HenriquePereiraRosa/hardware_projects/garage_door_colision_detector/docs/pics/Screenshot_20260823_183447_Gallery.jpg

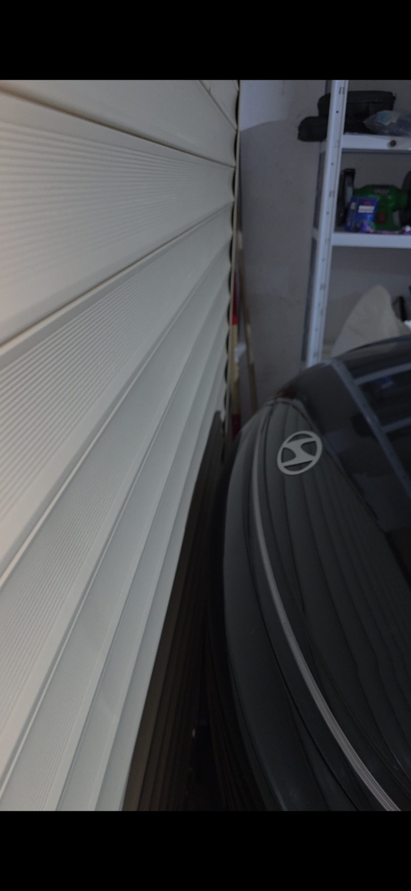
garage_door_colision_detector/docs/pics/Screenshot_20260823_183447_Gallery.jpg
