HenriquePereiraRosa/hardware_projects/garage_door_colision_detector/hardware/altium/scripts/SymbolProbe/report.txt

LIBENTRY|Resistor
DIRECT|object=25
DIRECT|object=27
DIRECT|object=37
DIRECT|object=37
DIRECT|object=18
DIRECT|object=18
DIRECT|object=18
DIRECT|object=18
DIRECT|TOTAL=8
CURRENT|object=25
CURRENT|object=27
CURRENT|object=37
CURRENT|object=37
CURRENT|object=18
CURRENT|object=18
CURRENT|object=18
CURRENT|object=18
CURRENT|TOTAL=8
CLONE|object=25
CLONE|object=27
CLONE|TOTAL=2
