HenriquePereiraRosa/hardware_projects/garage_door_colision_detector/output/pdf/GarageBeamSafety_Concept_Schematic_D0.pdf

GARAGE BEAM SAFETY | D0 CONCEPT - SHEET 1/4

# System architecture - same-side retroreflective option

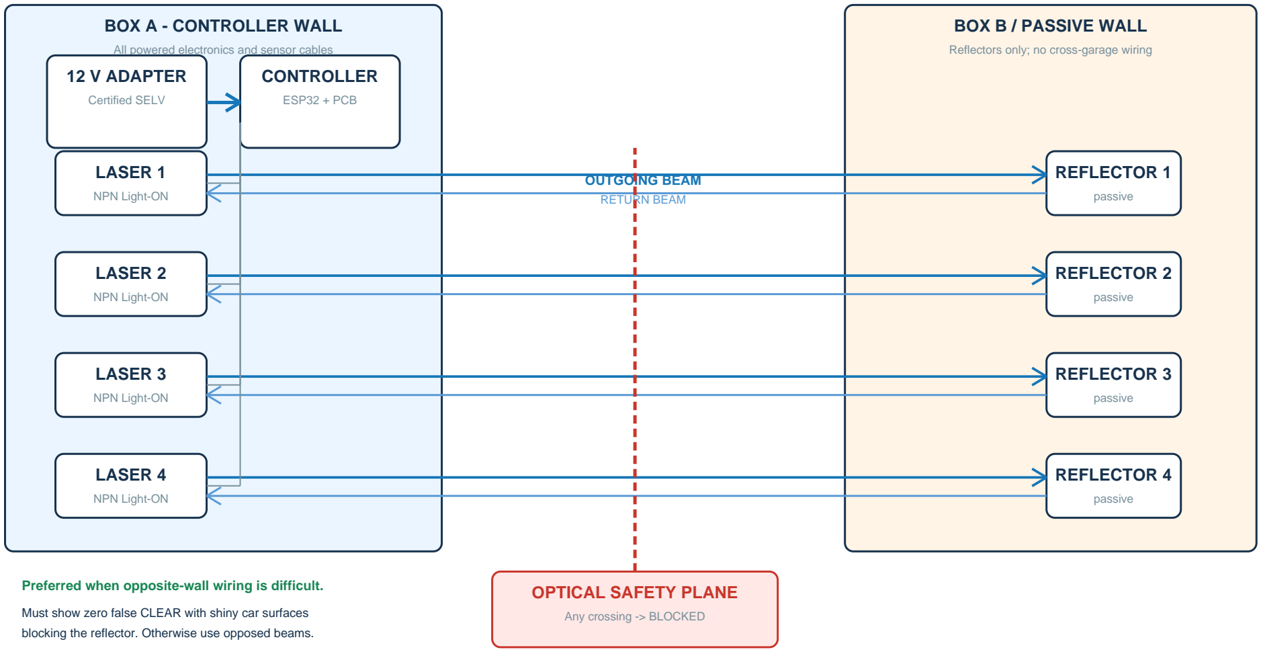
[picture p3: figure]
BOX A - CONTROLLER WALL; BOX B / PASSIVE WALL; Reflectors only; no cross-garage wiring; 12 V ADAPTER; Certified SELV; CONTROLLER; ESP32 + PCB; LASER 1; NPN Light-ON; REFLECTOR 1; passive; LASER 2; REFLECTOR 2; LASER 3; REFLECTOR 3; LASER 4; REFLECTOR 4; OUTGOING BEAM; RETURN BEAM; OPTICAL SAFETY PLANE; Any crossing -> BLOCKED

Concept schematic | 23 Aug 2026 | page 1 | Advisory detector only - no mains - no automatic door operation

All powered electronics and sensor cables

Preferred when opposite-wall wiring is difficult.

Must show zero false CLEAR with shiny car surfaces blocking the reflector. Otherwise use opposed beams.

GARAGE BEAM SAFETY | D0 CONCEPT - SHEET 2/4

# Power input, protected rails and ESP32 module

Concept schematic | 23 Aug 2026 | page 2 | Advisory detector only - no mains - no automatic door operation

J1 POWER
+12

0V

F1

PTC 1.1 A

D1 / Q1

reverse polarity

12V_SENSOR

TVS1

SMBJ18A

C1
470u / 25V

## 5 V BUCK

>=1 A continuous | 5V

C2
470u / 10V

## U1 - ESP32 DEVKIT

replaceable module on two socket headers

5V
VIN / 5V pin

3V3

## POWER DESIGN NOTES

- External adapter is certified 12 VDC SELV, recommended 2 A.
- No mains voltage enters either project box.
- 12V_SENSOR feeds all industrial optical sensors directly.
- Buck output must be verified at 5.0 V before inserting ESP32.
- 5 V bulk capacitor supports ESP32 Wi-Fi current peaks.
- Test points: TP12V, TP5V, TP3V3 and TPGND.

## RAIL SUMMARY

12V_SENSOR: field/sensor rail 5V: ESP32 module input 3V3: isolated logic pull-ups and indicators GND: controller logic return

# Four isolated fail-safe sensor inputs

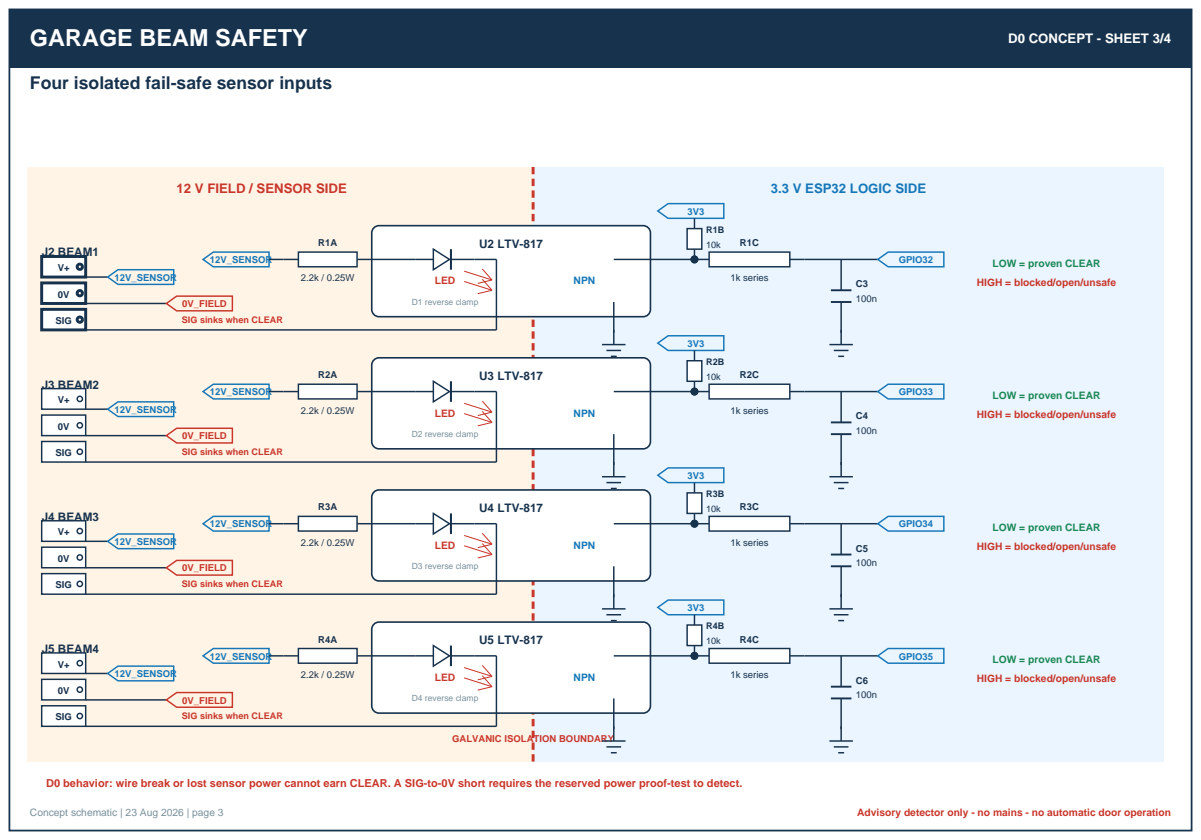
[picture p4: page 3]

LOW = proven CLEAR
HIGH = blocked/open/unsafe

0V_FIELD
SIG sinks when CLEAR

D0 behavior: wire break or lost sensor power cannot earn CLEAR. A SIG-to-0V short requires the reserved power proof-test to detect.

GARAGE BEAM SAFETY | D0 CONCEPT - SHEET 4/4

# ESP32 connections, indication and safety state behavior

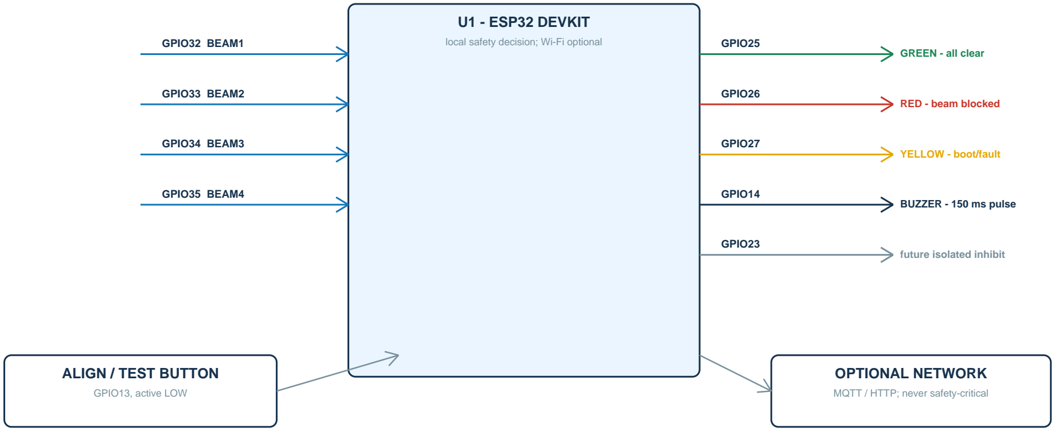
[picture p5: figure]
U1 - ESP32 DEVKIT; GPIO32 BEAM1; local safety decision; Wi-Fi optional; GPIO33 BEAM2; GPIO34 BEAM3; GPIO35 BEAM4; GPIO25; GREEN - all clear; GPIO26; RED - beam blocked; GPIO27; YELLOW - boot/fault; GPIO14; BUZZER - 150 ms pulse; GPIO23; future isolated inhibit; ALIGN / TEST BUTTON; GPIO13, active LOW; OPTIONAL NETWORK; MQTT / HTTP; never safety-critical

Concept schematic | 23 Aug 2026 | page 4 | Advisory detector only - no mains - no automatic door operation
BOOTING | SELF_TEST | CLEAR | BLOCKED | FAULT | priority: FAULT > BLOCKED > CLEAR

CLEAR requires every enabled beam continuously clear for 500 ms. BLOCKED follows the 5 ms electrical noise filter. Startup never shows green.
