HenriquePereiraRosa/hardware_projects/garage_door_colision_detector/output/pdf/GarageBeamSafety_Concept_Schematic_D1_Dark.pdf

GARAGE BEAM SAFETY | D1 DARK CONCEPT - SHEET 1/5

# System architecture - fixed polarized retroreflective trip lines

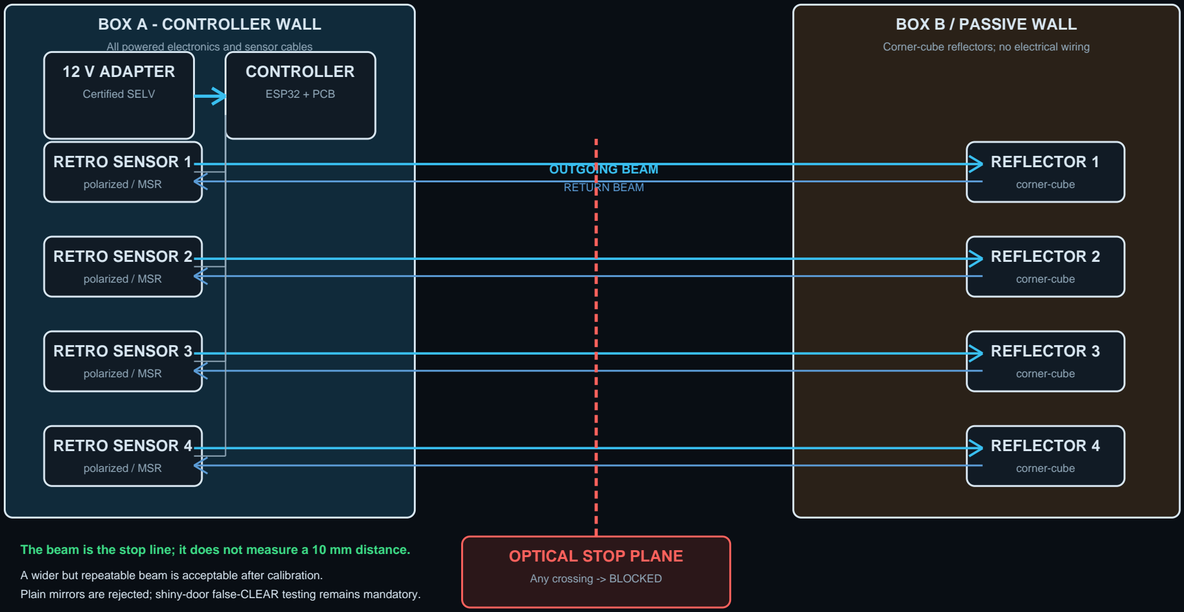
[picture p6: figure]
BOX A - CONTROLLER WALL; BOX B / PASSIVE WALL; Corner-cube reflectors; no electrical wiring; 12 V ADAPTER; Certified SELV; CONTROLLER; ESP32 + PCB; RETRO SENSOR 1; polarized / MSR; REFLECTOR 1; corner-cube; RETRO SENSOR 2; REFLECTOR 2; RETRO SENSOR 3; REFLECTOR 3; RETRO SENSOR 4; REFLECTOR 4; OUTGOING BEAM; RETURN BEAM; OPTICAL STOP PLANE; Any crossing -> BLOCKED

Concept schematic | 23 Aug 2026 | page 1 | Advisory detector only - no mains - no automatic door operation

All powered electronics and sensor cables

The beam is the stop line; it does not measure a 10 mm distance.

A wider but repeatable beam is acceptable after calibration.
Plain mirrors are rejected; shiny-door false-CLEAR testing remains mandatory.

GARAGE BEAM SAFETY | D1 DARK CONCEPT - SHEET 2/5

# Power input, protected rails and ESP32 module

Concept schematic | 23 Aug 2026 | page 2 | Advisory detector only - no mains - no automatic door operation

J1 POWER
+12

0V

F1

PTC 1.1 A

D1 / Q1

reverse polarity

12V_SENSOR

TVS1

SMBJ18A

C1
470u / 25V

## 5 V BUCK

>=1 A continuous | 5V

C2
470u / 10V

## U1 - ESP32 DEVKIT

replaceable module on two socket headers

5V
VIN / 5V pin

3V3

## POWER DESIGN NOTES

- External adapter is certified 12 VDC SELV, recommended 2 A.
- No mains voltage enters either project box.
- 12V_SENSOR feeds all industrial optical sensors directly.
- Buck output must be verified at 5.0 V before inserting ESP32.
- 5 V bulk capacitor supports ESP32 Wi-Fi current peaks.
- Test points: TP12V, TP5V, TP3V3 and TPGND.

## RAIL SUMMARY

12V_SENSOR: field/sensor rail 5V: ESP32 module input 3V3: isolated logic pull-ups and indicators GND: controller logic return

# Four isolated fail-safe sensor inputs

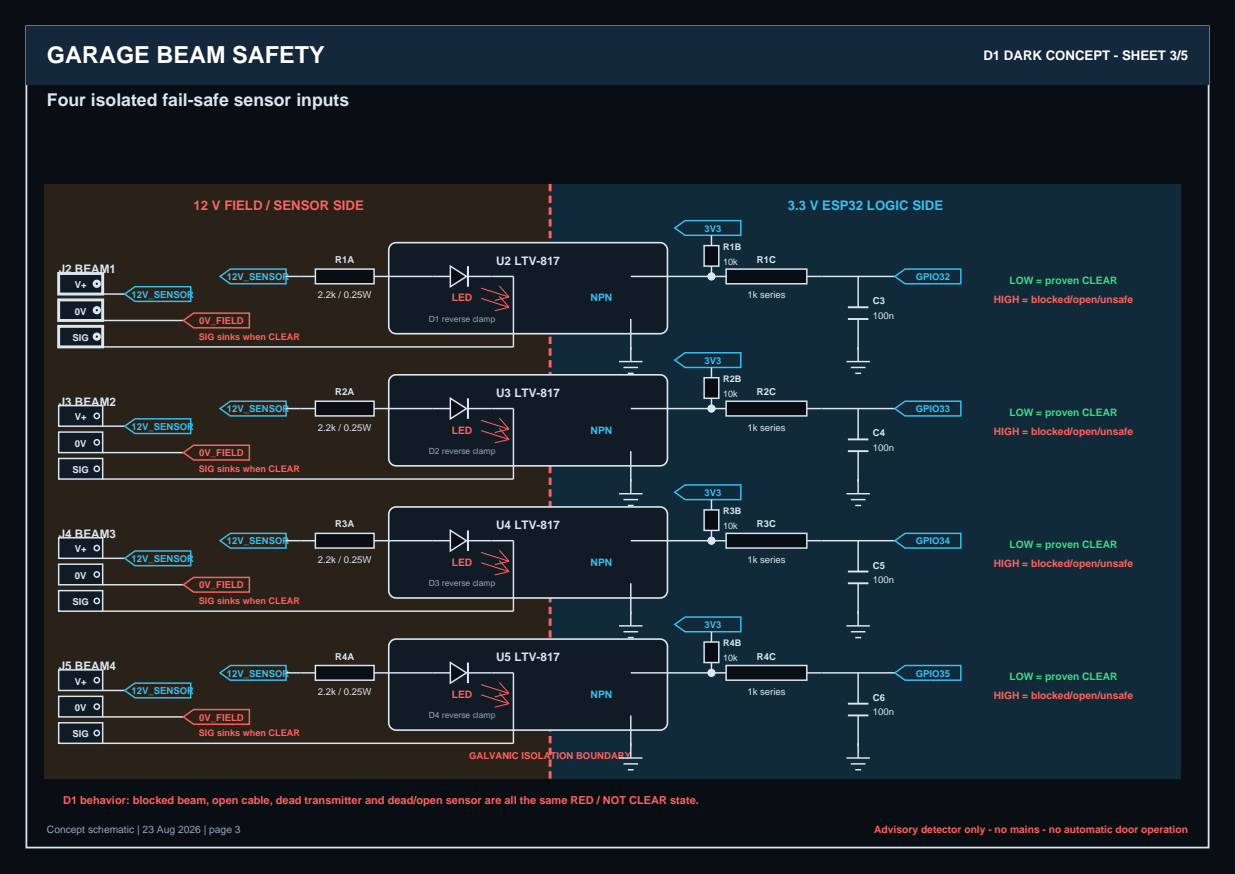
[picture p7: page 3]

LOW = proven CLEAR
HIGH = blocked/open/unsafe

0V_FIELD
SIG sinks when CLEAR

D1 behavior: blocked beam, open cable, dead transmitter and dead/open sensor are all the same RED / NOT CLEAR state.

GARAGE BEAM SAFETY | D1 DARK CONCEPT - SHEET 4/5

# ESP32 connections, redundant RGB indication and safety behavior

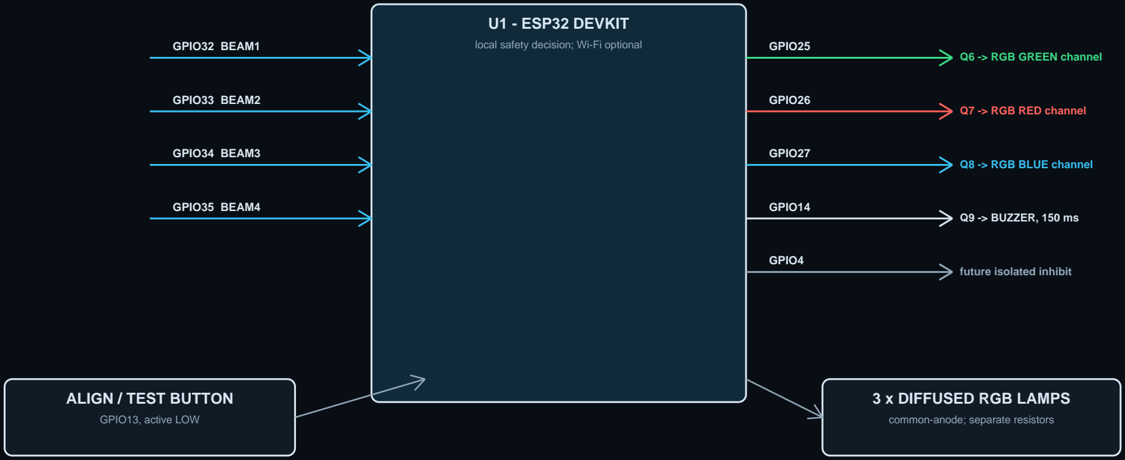
[picture p8: figure]
U1 - ESP32 DEVKIT; GPIO32 BEAM1; local safety decision; Wi-Fi optional; GPIO33 BEAM2; GPIO34 BEAM3; GPIO35 BEAM4; GPIO25; Q6 -> RGB GREEN channel; GPIO26; Q7 -> RGB RED channel; GPIO27; Q8 -> RGB BLUE channel; GPIO14; Q9 -> BUZZER, 150 ms; GPIO4; future isolated inhibit; ALIGN / TEST BUTTON; GPIO13, active LOW; 3 x DIFFUSED RGB LAMPS; common-anode; separate resistors

Concept schematic | 23 Aug 2026 | page 4 | Advisory detector only - no mains - no automatic door operation
BOOTING | SELF_TEST | CLEAR | BLOCKED | FAULT | priority: FAULT > BLOCKED > CLEAR

GREEN=clear. RED=blocked/no signal/dead sensor. AMBER=boot/unknown (red+green channels). Dark means no power.

GARAGE BEAM SAFETY | D1 DARK CONCEPT - SHEET 5/5

# Optional RF, door-motion and manual wake system

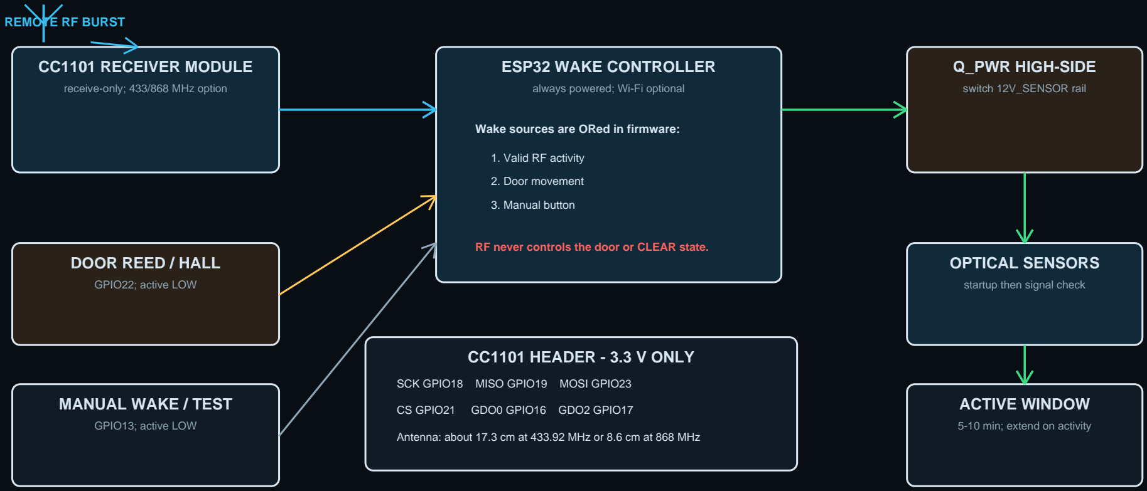
[picture p9: figure]
CC1101 RECEIVER MODULE; receive-only; 433/868 MHz option; REMOTE RF BURST; DOOR REED / HALL; GPIO22; active LOW; MANUAL WAKE / TEST; GPIO13; active LOW; ESP32 WAKE CONTROLLER; always powered; Wi-Fi optional; Wake sources are ORed in firmware:; 1. Valid RF activity; 2. Door movement; 3. Manual button; Q_PWR HIGH-SIDE; switch 12V_SENSOR rail; OPTICAL SENSORS; startup then signal check; ACTIVE WINDOW; 5-10 min; extend on activity; CC1101 HEADER - 3.3 V ONLY; SCK GPIO18 MISO GPIO19 MOSI GPIO23; CS GPIO21 GDO0 GPIO16 GDO2 GPIO17

Concept schematic | 23 Aug 2026 | page 5 | Advisory detector only - no mains - no automatic door operation

RF never controls the door or CLEAR state.

Antenna: about 17.3 cm at 433.92 MHz or 8.6 cm at 868 MHz

## WAKE SEQUENCE

STANDBY -> wake detected -> AMBER -> sensor power ON -> startup delay -> 500 ms clear proof -> GREEN

Any missing optical signal becomes RED. A missed RF burst is covered by the door switch or manual button.
