HenriquePereiraRosa/hardware_projects/garage_door_colision_detector/output/pdf/GarageBeamSafety_Concept_Schematic_D2_Dark.pdf

# Mounting overview - fixed hardware, optical plane and driver indication

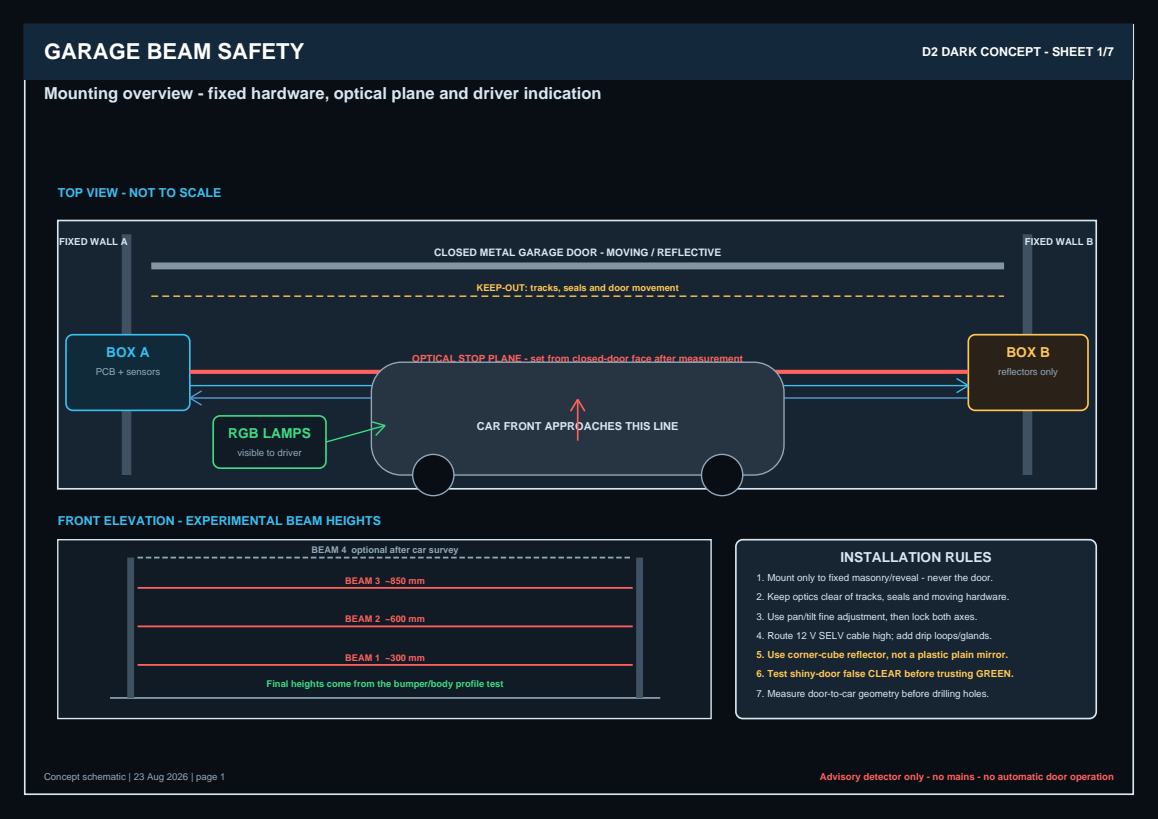
[picture p10: page 1]
GARAGE BEAM SAFETY; D2 DARK CONCEPT - SHEET 1/7; Concept schematic | 23 Aug 2026 | page 1; Advisory detector only - no mains - no automatic door operation; FIXED WALL A; FIXED WALL B; BOX A; PCB + sensors; BOX B; reflectors only; BEAM 1 ~300 mm; BEAM 2 ~600 mm; BEAM 3 ~850 mm; INSTALLATION RULES

TOP VIEW - NOT TO SCALE

CLOSED METAL GARAGE DOOR - MOVING / REFLECTIVE

KEEP-OUT: tracks, seals and door movement

OPTICAL STOP PLANE - set from closed-door face after measurement

CAR FRONT APPROACHES THIS LINE RGB LAMPS

visible to driver

FRONT ELEVATION - EXPERIMENTAL BEAM HEIGHTS

BEAM 4 optional after car survey

1. Mount only to fixed masonry/reveal - never the door.
2. Keep optics clear of tracks, seals and moving hardware.
3. Use pan/tilt fine adjustment, then lock both axes.
4. Route 12 V SELV cable high; add drip loops/glands.
5. Use corner-cube reflector, not a plastic plain mirror.
6. Test shiny-door false CLEAR before trusting GREEN.
7. Measure door-to-car geometry before drilling holes.

Final heights come from the bumper/body profile test

GARAGE BEAM SAFETY | D2 DARK CONCEPT - SHEET 2/7

# System architecture - fixed polarized retroreflective trip lines

BOX A - CONTROLLER WALL; BOX B / PASSIVE WALL; Corner-cube reflectors; no electrical wiring; 12 V ADAPTER; Certified SELV; CONTROLLER; ESP32 + PCB; RETRO SENSOR 1; polarized / MSR; REFLECTOR 1; corner-cube; RETRO SENSOR 2; REFLECTOR 2; RETRO SENSOR 3; REFLECTOR 3; RETRO SENSOR 4; REFLECTOR 4; OUTGOING BEAM; RETURN BEAM; OPTICAL STOP PLANE; Any crossing -> BLOCKED

Concept schematic | 23 Aug 2026 | page 2 | Advisory detector only - no mains - no automatic door operation

All powered electronics and sensor cables

The beam is the stop line; it does not measure a 10 mm distance.

A wider but repeatable beam is acceptable after calibration.
Plain mirrors are rejected; shiny-door false-CLEAR testing remains mandatory.

GARAGE BEAM SAFETY | D2 DARK CONCEPT - SHEET 3/7

# Power input, protected rails and ESP32 module

Concept schematic | 23 Aug 2026 | page 3 | Advisory detector only - no mains - no automatic door operation

J1 POWER
+12

0V

F1

PTC 1.1 A

D1 / Q1

reverse polarity

12V_SENSOR

TVS1

SMBJ18A

C1
470u / 25V

## 5 V BUCK

>=1 A continuous | 5V

C2
470u / 10V

## U1 - ESP32 DEVKIT

replaceable module on two socket headers

5V
VIN / 5V pin

3V3

## POWER DESIGN NOTES

- External adapter is certified 12 VDC SELV, recommended 2 A.
- No mains voltage enters either project box.
- 12V_SENSOR feeds all industrial optical sensors directly.
- Buck output must be verified at 5.0 V before inserting ESP32.
- 5 V bulk capacitor supports ESP32 Wi-Fi current peaks.
- Test points: TP12V, TP5V, TP3V3 and TPGND.

## RAIL SUMMARY

12V_SENSOR: field/sensor rail 5V: ESP32 module input 3V3: isolated logic pull-ups and indicators GND: controller logic return

# Four isolated fail-safe sensor inputs

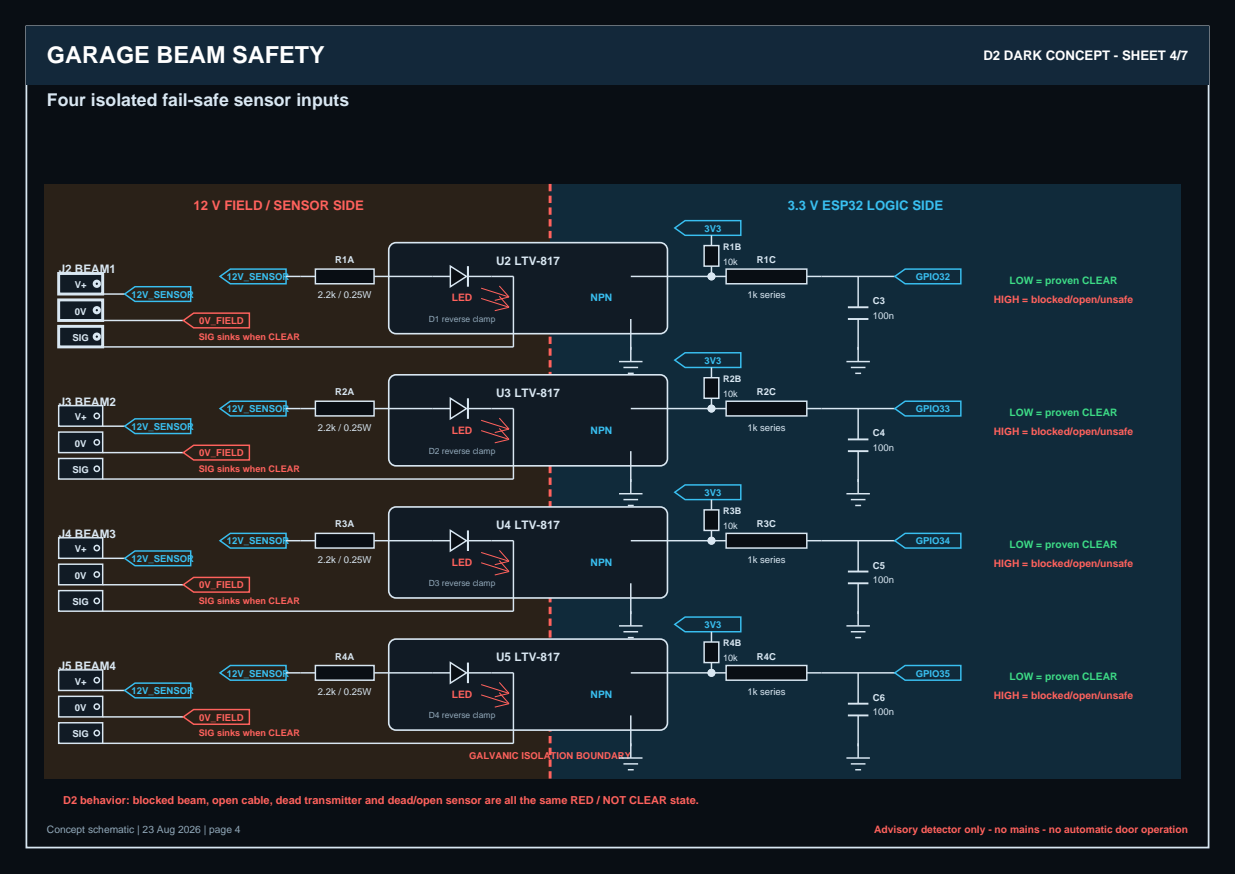
[picture p11: page 4]

LOW = proven CLEAR
HIGH = blocked/open/unsafe

0V_FIELD
SIG sinks when CLEAR

D2 behavior: blocked beam, open cable, dead transmitter and dead/open sensor are all the same RED / NOT CLEAR state.

GARAGE BEAM SAFETY | D2 DARK CONCEPT - SHEET 5/7

# ESP32 connections, redundant RGB indication and safety behavior

U1 - ESP32 DEVKIT; GPIO32 BEAM1; local safety decision; Wi-Fi optional; GPIO33 BEAM2; GPIO34 BEAM3; GPIO35 BEAM4; GPIO25; Q6 -> RGB GREEN channel; GPIO26; Q7 -> RGB RED channel; GPIO27; Q8 -> RGB BLUE channel; GPIO14; Q9 -> BUZZER, 150 ms; GPIO4; future isolated inhibit; ALIGN / TEST BUTTON; GPIO13, active LOW; 3 x DIFFUSED RGB LAMPS; common-anode; separate resistors

Concept schematic | 23 Aug 2026 | page 5 | Advisory detector only - no mains - no automatic door operation
BOOTING | SELF_TEST | CLEAR | BLOCKED | FAULT | priority: FAULT > BLOCKED > CLEAR

GREEN=clear. RED=blocked/no signal/dead sensor. AMBER=boot/unknown (red+green channels). Dark means no power.

GARAGE BEAM SAFETY | D2 DARK CONCEPT - SHEET 6/7

# Optional RF, door-motion and manual wake system

CC1101 RECEIVER MODULE; receive-only; 433/868 MHz option; REMOTE RF BURST; DOOR REED / HALL; GPIO22; active LOW; MANUAL WAKE / TEST; GPIO13; active LOW; ESP32 WAKE CONTROLLER; always powered; Wi-Fi optional; Wake sources are ORed in firmware:; 1. Valid RF activity; 2. Door movement; 3. Manual button; Q_PWR HIGH-SIDE; switch 12V_SENSOR rail; OPTICAL SENSORS; startup then signal check; ACTIVE WINDOW; 5-10 min; extend on activity; CC1101 HEADER - 3.3 V ONLY; SCK GPIO18 MISO GPIO19 MOSI GPIO23; CS GPIO21 GDO0 GPIO16 GDO2 GPIO17

Concept schematic | 23 Aug 2026 | page 6 | Advisory detector only - no mains - no automatic door operation

RF never controls the door or CLEAR state.

Antenna: about 17.3 cm at 433.92 MHz or 8.6 cm at 868 MHz

## WAKE SEQUENCE

STANDBY -> wake detected -> AMBER -> sensor power ON -> startup delay -> 500 ms clear proof -> GREEN

Any missing optical signal becomes RED. A missed RF burst is covered by the door switch or manual button.

# Prototype purchasing BOM - buy one beam first, then scale only after validation

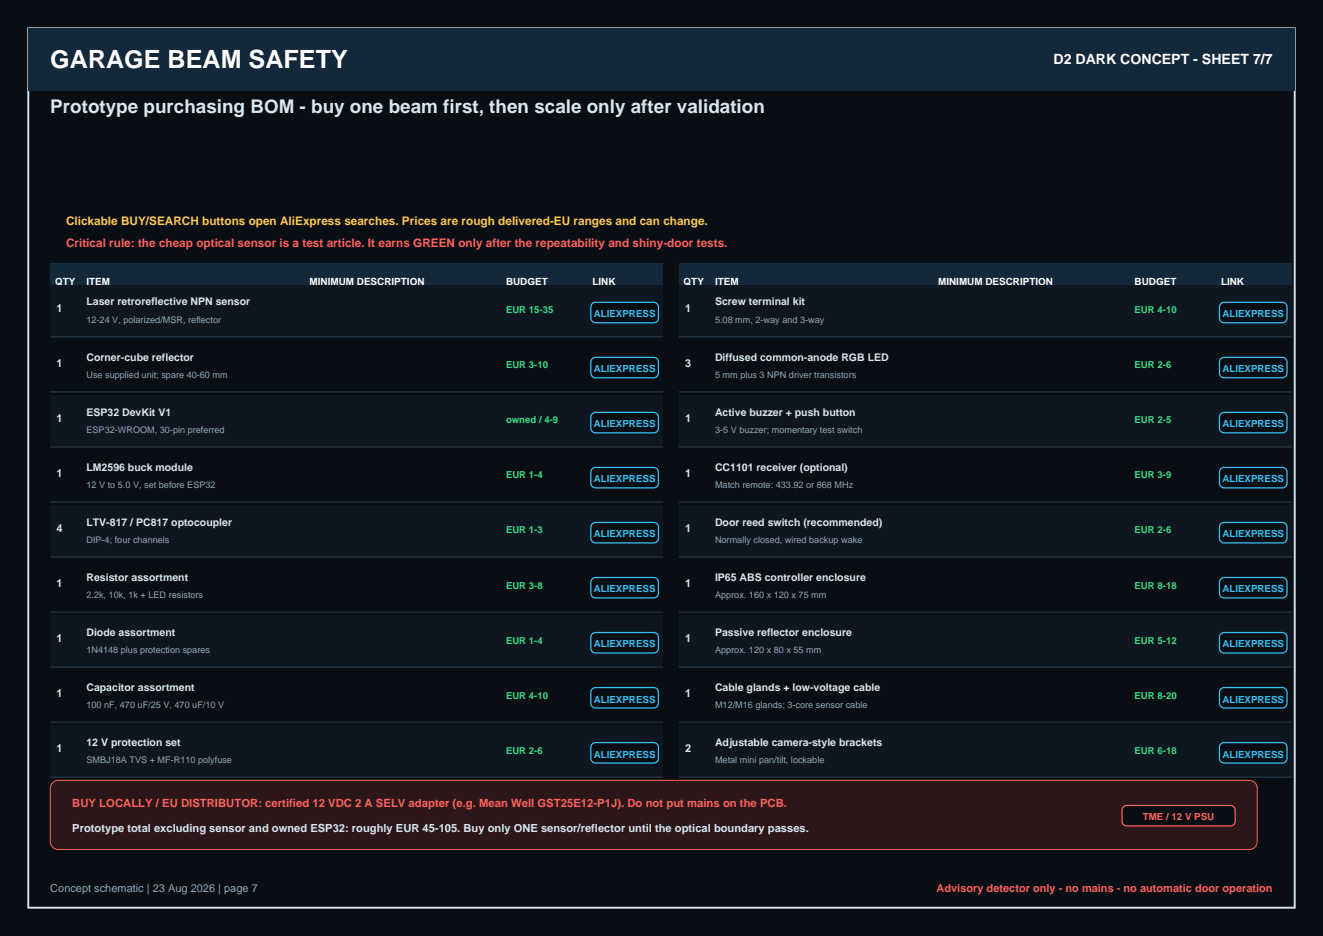
[picture p12: page 7]
GARAGE BEAM SAFETY; D2 DARK CONCEPT - SHEET 7/7; Concept schematic | 23 Aug 2026 | page 7; Advisory detector only - no mains - no automatic door operation; QTY ITEM; MINIMUM DESCRIPTION; BUDGET; LINK; EUR 15-35; ALIEXPRESS; EUR 3-10; ESP32 DevKit V1; ESP32-WROOM, 30-pin preferred; owned / 4-9; EUR 1-4; EUR 1-3; Resistor assortment; 2.2k, 10k, 1k + LED resistors; EUR 3-8; EUR 4-10; EUR 2-6; EUR 2-5; EUR 3-9; EUR 8-18; EUR 5-12; EUR 8-20; EUR 6-18; TME / 12 V PSU

Clickable BUY/SEARCH buttons open AliExpress searches. Prices are rough delivered-EU ranges and can change.
Critical rule: the cheap optical sensor is a test article. It earns GREEN only after the repeatability and shiny-door tests.

Laser retroreflective NPN sensor
12-24 V, polarized/MSR, reflector

Screw terminal kit
5.08 mm, 2-way and 3-way

Corner-cube reflector
Use supplied unit; spare 40-60 mm

Diffused common-anode RGB LED
5 mm plus 3 NPN driver transistors

Active buzzer + push button
3-5 V buzzer; momentary test switch

LM2596 buck module
12 V to 5.0 V, set before ESP32

CC1101 receiver (optional)
Match remote: 433.92 or 868 MHz

LTV-817 / PC817 optocoupler
DIP-4; four channels

Door reed switch (recommended)
Normally closed, wired backup wake

IP65 ABS controller enclosure
Approx. 160 x 120 x 75 mm

Diode assortment
1N4148 plus protection spares

Passive reflector enclosure
Approx. 120 x 80 x 55 mm

Capacitor assortment

Cable glands + low-voltage cable
M12/M16 glands; 3-core sensor cable

12 V protection set
SMBJ18A TVS + MF-R110 polyfuse

Adjustable camera-style brackets
Metal mini pan/tilt, lockable

BUY LOCALLY / EU DISTRIBUTOR: certified 12 VDC 2 A SELV adapter (e.g. Mean Well GST25E12-P1J). Do not put mains on the PCB.
Prototype total excluding sensor and owned ESP32: roughly EUR 45-105. Buy only ONE sensor/reflector until the optical boundary passes.
