HenriquePereiraRosa/hardware_projects/garage_door_colision_detector/output/pdf/GarageBeamSafety_Concept_Schematic_D3_Dark.pdf

# Mounting overview - fixed hardware, optical plane and driver indication

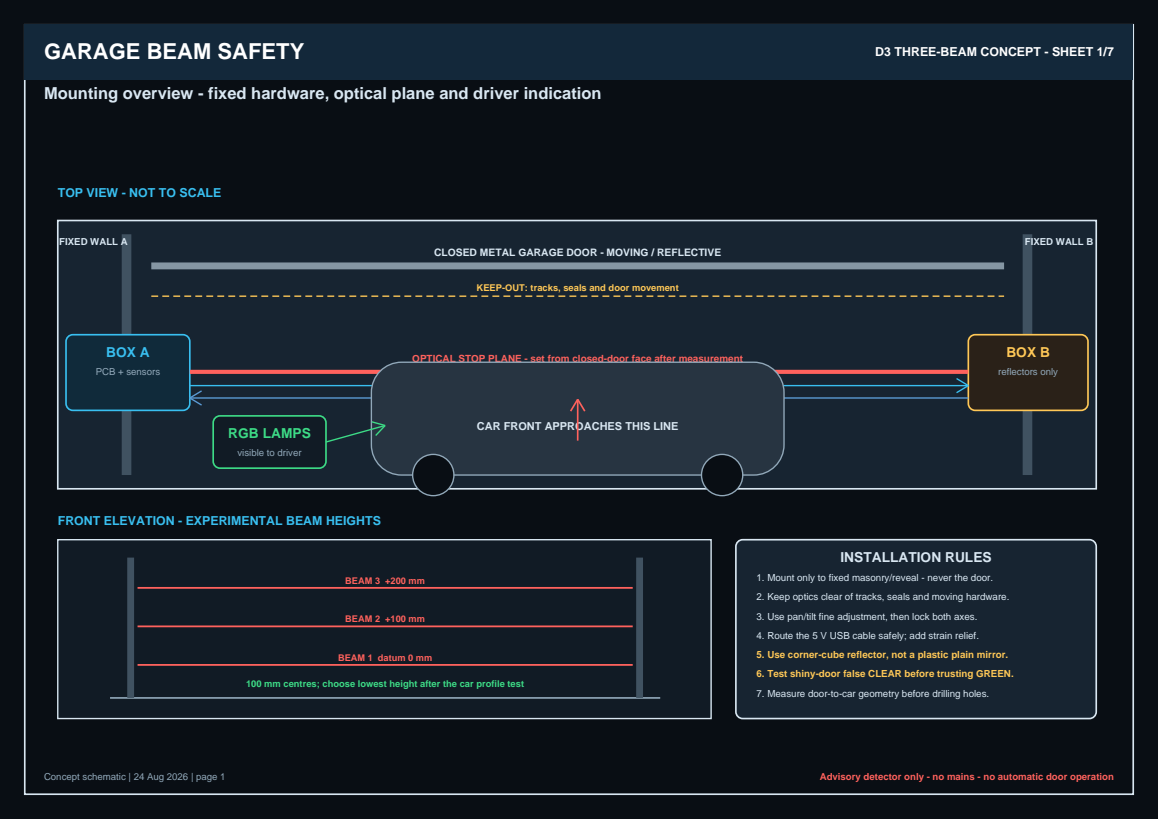
[picture p13: page 1]
GARAGE BEAM SAFETY; D3 THREE-BEAM CONCEPT - SHEET 1/7; Concept schematic | 24 Aug 2026 | page 1; Advisory detector only - no mains - no automatic door operation; FIXED WALL A; FIXED WALL B; BOX A; PCB + sensors; BOX B; reflectors only; BEAM 2 +100 mm; BEAM 3 +200 mm; INSTALLATION RULES

TOP VIEW - NOT TO SCALE

CLOSED METAL GARAGE DOOR - MOVING / REFLECTIVE

KEEP-OUT: tracks, seals and door movement

OPTICAL STOP PLANE - set from closed-door face after measurement

CAR FRONT APPROACHES THIS LINE RGB LAMPS

visible to driver

FRONT ELEVATION - EXPERIMENTAL BEAM HEIGHTS

1. Mount only to fixed masonry/reveal - never the door.
2. Keep optics clear of tracks, seals and moving hardware.
3. Use pan/tilt fine adjustment, then lock both axes.
4. Route the 5 V USB cable safely; add strain relief.
5. Use corner-cube reflector, not a plastic plain mirror.
6. Test shiny-door false CLEAR before trusting GREEN.
7. Measure door-to-car geometry before drilling holes.

BEAM 1 datum 0 mm

100 mm centres; choose lowest height after the car profile test

GARAGE BEAM SAFETY | D3 THREE-BEAM CONCEPT - SHEET 2/7

# System architecture - fixed polarized retroreflective trip lines

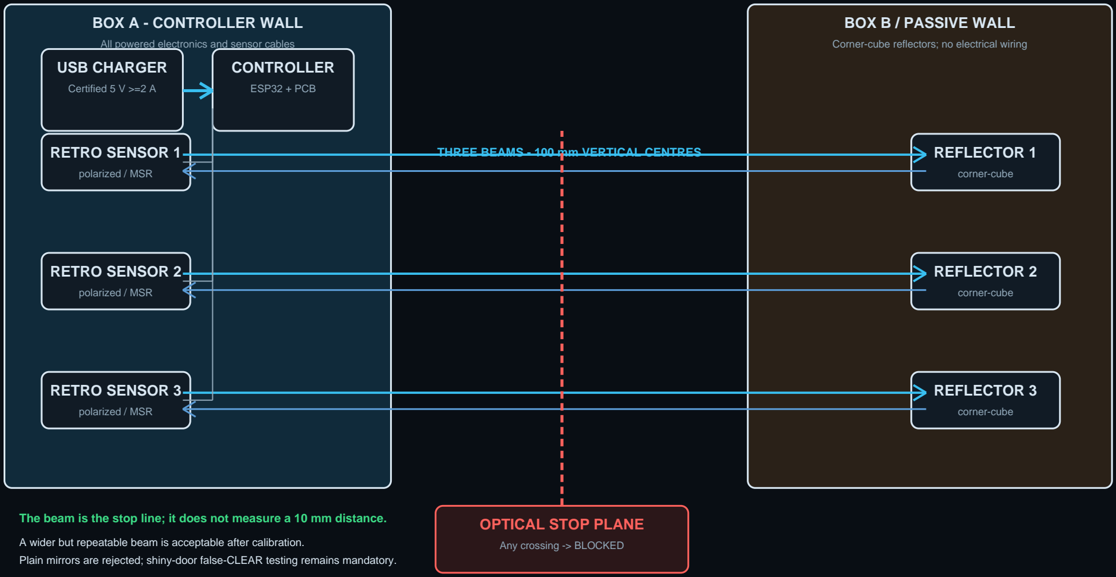
[picture p14: figure]
BOX A - CONTROLLER WALL; BOX B / PASSIVE WALL; Corner-cube reflectors; no electrical wiring; USB CHARGER; Certified 5 V >=2 A; CONTROLLER; ESP32 + PCB; RETRO SENSOR 1; polarized / MSR; REFLECTOR 1; corner-cube; RETRO SENSOR 2; REFLECTOR 2; RETRO SENSOR 3; REFLECTOR 3; THREE BEAMS - 100 mm VERTICAL CENTRES; OPTICAL STOP PLANE; Any crossing -> BLOCKED

Concept schematic | 24 Aug 2026 | page 2 | Advisory detector only - no mains - no automatic door operation

All powered electronics and sensor cables

The beam is the stop line; it does not measure a 10 mm distance.

A wider but repeatable beam is acceptable after calibration.
Plain mirrors are rejected; shiny-door false-CLEAR testing remains mandatory.

GARAGE BEAM SAFETY | D3 THREE-BEAM CONCEPT - SHEET 3/7

# USB-C input, protected 5 V rail and 12 V sensor boost

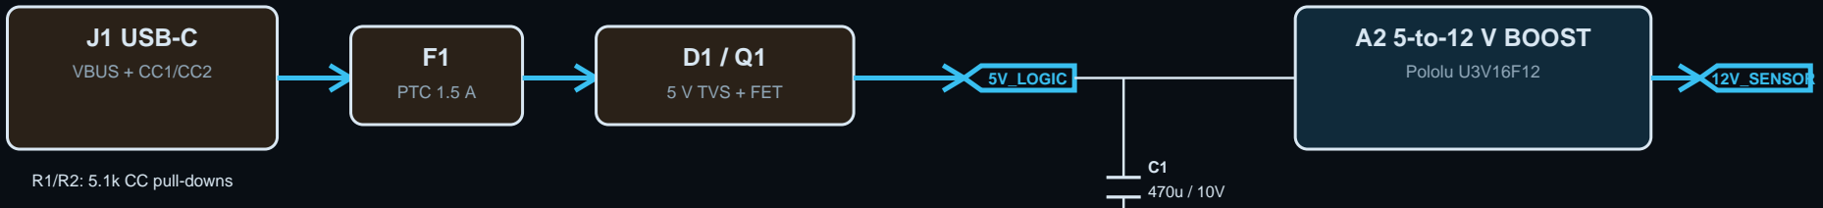
[picture p15: figure]
J1 USB-C; VBUS + CC1/CC2; R1/R2: 5.1k CC pull-downs; PTC 1.5 A; 5 V TVS + FET; 5V_LOGIC; A2 5-to-12 V BOOST; Pololu U3V16F12; 12V_SENSOR

Concept schematic | 24 Aug 2026 | page 3 | Advisory detector only - no mains - no automatic door operation

## A1 - ESP32 DEVKIT

replaceable module on socket headers

5V_LOGIC
VIN / 5V pin

3V3

## POWER DESIGN NOTES

- External certified USB charger: regulated 5 V, at least 2 A.
- Plain USB-C 5 V sink; USB Power Delivery is not required.
- ESP32 uses protected 5V_LOGIC directly at VIN/5V.
- Boost converter supplies 12 V only to the three sensors.
- Never connect an industrial sensor directly to USB VBUS.
- Test points: VBUS, 5V, 12V, 3V3 and GND.

## RAIL SUMMARY

5V_LOGIC: USB/ESP32 rail 12V_SENSOR: boosted field rail 3V3: logic pull-ups Parts: 0805/SOD-123/SOT-23

# Three isolated fail-safe sensor inputs at 100 mm centres

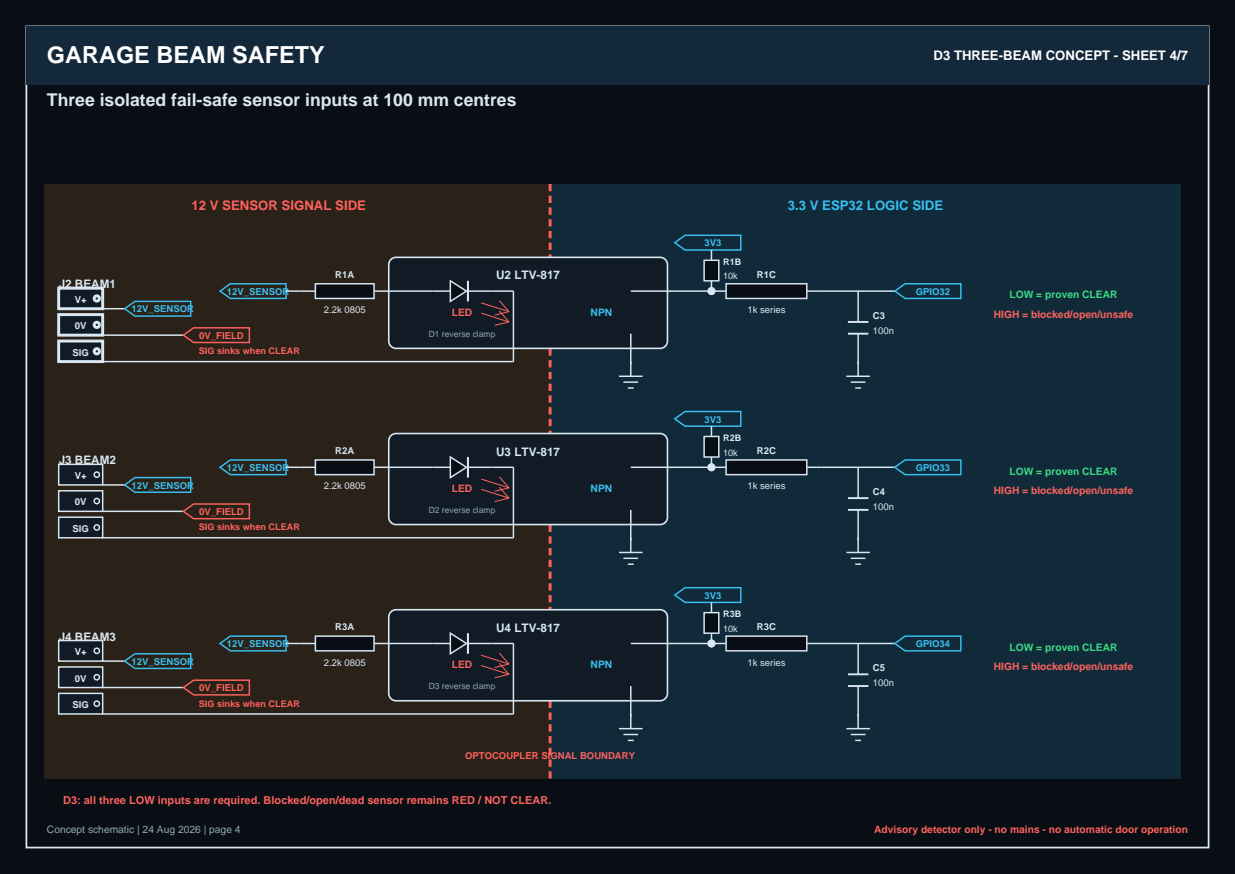
[picture p16: page 4]

LOW = proven CLEAR
HIGH = blocked/open/unsafe

0V_FIELD
SIG sinks when CLEAR

D3: all three LOW inputs are required. Blocked/open/dead sensor remains RED / NOT CLEAR.

GARAGE BEAM SAFETY | D3 THREE-BEAM CONCEPT - SHEET 5/7

# ESP32 connections, status indication and safety behavior

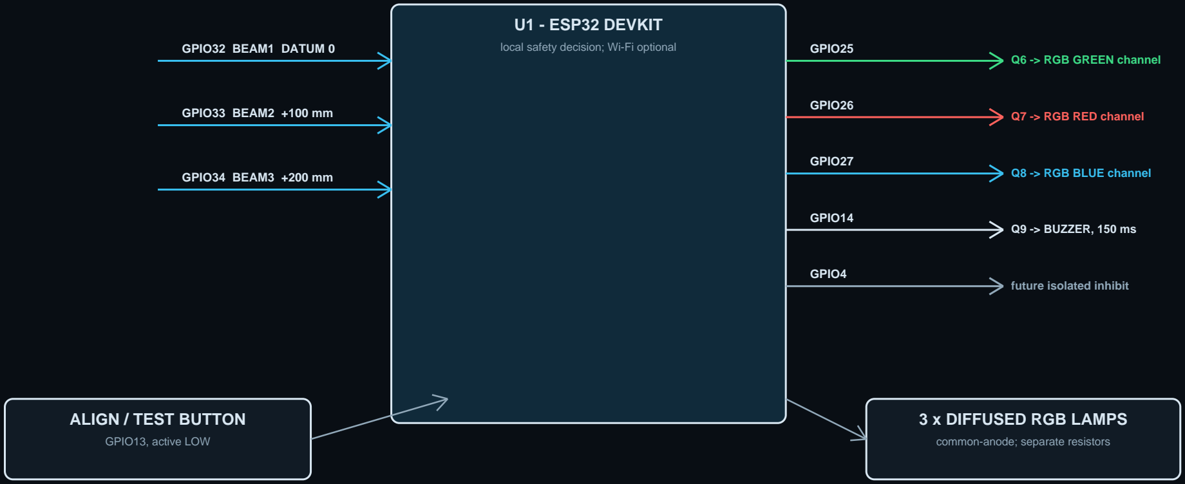
[picture p17: figure]
U1 - ESP32 DEVKIT; GPIO32 BEAM1 DATUM 0; local safety decision; Wi-Fi optional; GPIO33 BEAM2 +100 mm; GPIO34 BEAM3 +200 mm; GPIO25; Q6 -> RGB GREEN channel; GPIO26; Q7 -> RGB RED channel; GPIO27; Q8 -> RGB BLUE channel; GPIO14; Q9 -> BUZZER, 150 ms; GPIO4; future isolated inhibit; ALIGN / TEST BUTTON; GPIO13, active LOW; 3 x DIFFUSED RGB LAMPS; common-anode; separate resistors

Concept schematic | 24 Aug 2026 | page 5 | Advisory detector only - no mains - no automatic door operation
BOOTING | SELF_TEST | CLEAR | BLOCKED | FAULT | priority: FAULT > BLOCKED > CLEAR

GREEN=clear. RED=blocked/no signal/dead sensor. AMBER=boot/unknown (red+green channels). Dark means no power.

GARAGE BEAM SAFETY | D3 THREE-BEAM CONCEPT - SHEET 6/7

# Optional RF, door-motion and manual wake system

CC1101 RECEIVER MODULE; receive-only; 433/868 MHz option; REMOTE RF BURST; DOOR REED / HALL; GPIO22; active LOW; MANUAL WAKE / TEST; GPIO13; active LOW; ESP32 WAKE CONTROLLER; always powered; Wi-Fi optional; Wake sources are ORed in firmware:; 1. Valid RF activity; 2. Door movement; 3. Manual button; Q_PWR HIGH-SIDE; switch 12V_SENSOR rail; OPTICAL SENSORS; startup then signal check; ACTIVE WINDOW; 5-10 min; extend on activity; CC1101 HEADER - 3.3 V ONLY; SCK GPIO18 MISO GPIO19 MOSI GPIO23; CS GPIO21 GDO0 GPIO16 GDO2 GPIO17

Concept schematic | 24 Aug 2026 | page 6 | Advisory detector only - no mains - no automatic door operation

RF never controls the door or CLEAR state.

Antenna: about 17.3 cm at 433.92 MHz or 8.6 cm at 868 MHz

## WAKE SEQUENCE

STANDBY -> wake detected -> AMBER -> sensor power ON -> startup delay -> 500 ms clear proof -> GREEN

Any missing optical signal becomes RED. A missed RF burst is covered by the door switch or manual button.

GARAGE BEAM SAFETY | D3 THREE-BEAM CONCEPT - SHEET 7/7

# D3 purchasing summary - three beams, USB-C and hand-solderable SMD

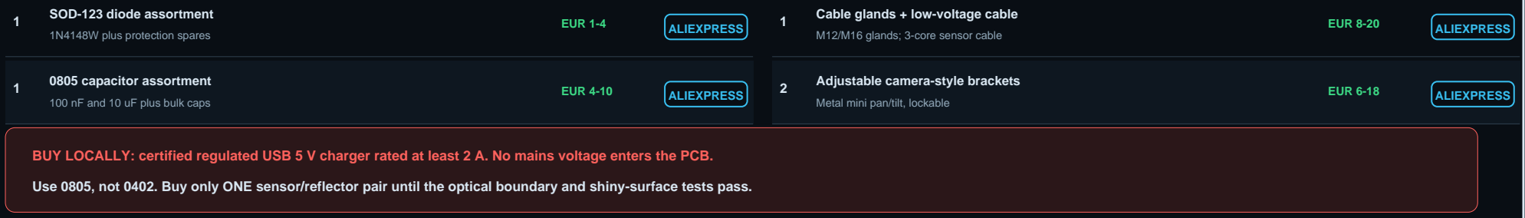
[picture p18: figure]
SOD-123 diode assortment; 1N4148W plus protection spares; EUR 1-4; ALIEXPRESS; 0805 capacitor assortment; 100 nF and 10 uF plus bulk caps; EUR 4-10; Cable glands + low-voltage cable; M12/M16 glands; 3-core sensor cable; EUR 8-20; Adjustable camera-style brackets; Metal mini pan/tilt, lockable; EUR 6-18

Concept schematic | 24 Aug 2026 | page 7 | Advisory detector only - no mains - no automatic door operation

Clickable BUY/SEARCH buttons open AliExpress searches. Prices are rough delivered-EU ranges and can change. Critical rule: the cheap optical sensor is a test article. It earns GREEN only after the repeatability and shiny-door tests.

QTY ITEM | MINIMUM DESCRIPTION | BUDGET | LINK

3

Laser retroreflective NPN sensor Buy one first; validate before other two | | EUR 45-105 | ALIEXPRESS (https://www.aliexpress.com/w/wholesale-laser-retroreflective-photoelectric-sensor-npn.html)

3

Corner-cube reflector
Matched to sensor; 100 mm centres
EUR 9-30 | ALIEXPRESS (https://www.aliexpress.com/w/wholesale-photoelectric-sensor-reflector.html)

1

ESP32 DevKit V1
ESP32-WROOM, 30-pin preferred
owned / 4-9 | ALIEXPRESS (https://www.aliexpress.com/w/wholesale-esp32-devkit-v1-30-pin.html)

1

USB-C + protected input
5.1k CC; PTC; 5V TVS; P-FET
EUR 3-8 | ALIEXPRESS (https://www.aliexpress.com/w/wholesale-usb-c-female-connector-board.html)

1

5-to-12 V boost
Pololu U3V16F12 preferred
EUR 7-12 | ALIEXPRESS (https://www.pololu.com/product/4945)

3

LTV-817S optocoupler
SMD-4; three channels
EUR 1-3 | ALIEXPRESS (https://www.aliexpress.com/w/wholesale-ltv-817-optocoupler.html)

1

0805 resistor assortment
2.2k, 10k, 5.1k, 1k, 330R
EUR 3-8 | ALIEXPRESS (https://www.aliexpress.com/w/wholesale-0805-resistor-kit.html)
QTY ITEM | MINIMUM DESCRIPTION | BUDGET | LINK

1

Screw terminal kit 5.08 mm, 2-way and 3-way | | EUR 4-10 | ALIEXPRESS (https://www.aliexpress.com/w/wholesale-5.08mm-screw-terminal-block-kit.html)

3

Diffused common-anode RGB LED
5 mm plus 3 NPN driver transistors
EUR 2-6 | ALIEXPRESS (https://www.aliexpress.com/w/wholesale-5mm-diffused-common-anode-rgb-led.html)

1

Active buzzer + push button 3-5 V buzzer; momentary test switch

EUR 2-5 | ALIEXPRESS (https://www.aliexpress.com/w/wholesale-active-buzzer-push-button-kit.html)

1

CC1101 receiver (optional) Match remote: 433.92 or 868 MHz

EUR 3-9 | ALIEXPRESS (https://www.aliexpress.com/w/wholesale-cc1101-433mhz-antenna.html)

1

Door reed switch (recommended) Normally closed, wired backup wake

EUR 2-6 | ALIEXPRESS (https://www.aliexpress.com/w/wholesale-wired-door-reed-switch-nc.html)

1

Sensor/controller carrier
PCB 50 x 240 mm; three datums
TBD | ALIEXPRESS (https://www.aliexpress.com/w/wholesale-custom-pcb-prototype.html)

1

Passive reflector carrier
PCB 30 x 240 mm; no copper
TBD | ALIEXPRESS (https://www.aliexpress.com/w/wholesale-custom-pcb-prototype.html)

BUY LOCALLY: certified regulated USB 5 V charger rated at least 2 A. No mains voltage enters the PCB.

Use 0805, not 0402. Buy only ONE sensor/reflector pair until the optical boundary and shiny-surface tests pass.
