HenriquePereiraRosa/hardware_projects/garage_door_colision_detector/hardware/altium/deprecated/2026-09-20-unused-schematic-copies/README.md

# Unused schematic copies archived 2026-09-20

These three older files were moved from `hardware/altium/sch` after confirming
that the active GarageBeamSafety.PrjPcb and its overview sheet links do not use them:

- 01_Power_Control.SchDoc
- 02_Beam_Inputs.SchDoc
- 03_UI_Outputs.SchDoc

No schematic contents were changed and no files were permanently deleted.
The active replacement pages remain in `History/native-parts-20260914-224022`
as 02_Power_Control.SchDoc, 03_Beam_Inputs.SchDoc, and 04_UI_Outputs.SchDoc.
Do not delete that History directory: the active project still uses those files.

The project and six active schematics were backed up before the link repair in
`recovery/project-links-20260920-174843`. Legacy repair scripts may refer to the
old filenames; do not rerun them as part of this recovery.
