HenriquePereiraRosa/hardware_projects/garage_door_colision_detector/hardware/altium/deprecated/2026-09-10-folder-reorganization/originals/hardware/altium/ALTIUM_QUICK_REFERENCE.html

Garage Beam Safety

# Altium Designer quick reference

Working cheat sheet for GarageBeamSafety.PrjPcb. Click inside the schematic or PCB editor first because shortcuts are context-sensitive. During any command, press Shift+F1 for context help.

## 3D board and component placement — essentials

What you want to do | How
Enter / leave 3D view | Press 3 for 3D and 2 for normal PCB editing.
Rotate the whole 3D board | Hold Shift, then hold the right mouse button and drag. Release the mouse, then Shift.
Flip to the opposite board face | Press V, then B.
Zoom / pan in 3D | Mouse wheel to zoom; hold the right mouse button and drag to pan.
Place a component | In 2D view press P, C, choose the part, move it, then left-click.
Move an existing component | Hover and drag it, or press M, C and click the component.
Rotate while moving | Press Space for 90° counter-clockwise; Shift+Space for clockwise.
Move component to bottom | While it is floating, press L. Altium mirrors the footprint onto the other side.
Set exact position / rotation | Select the component, press F11, then edit Location X/Y, Rotation, and Layer.

Fastest habit: do placement in 2 (2D), press Space while the part is attached to the cursor, then press 3 to check height and enclosure fit.

## Where to get real components with 3D models

1. Best: download the STEP model and drawing from the exact component manufacturer's product page. The manufacturer datasheet remains the authority for pin numbers and dimensions.
2. Inside Altium: open View → Panels → Manufacturer Part Search. Search the exact manufacturer part number and prefer entries marked ECAD Ready, with symbol, footprint, and 3D model. Altium's own documentation distinguishes these qualified models from generic/unqualified entries.
3. Good secondary sources: SnapMagic (https://www.snapmagic.com/) (formerly SnapEDA), SamacSys Component Search Engine (https://componentsearchengine.com/), and Ultra Librarian (https://www.ultralibrarian.com/). Always compare pad dimensions, pin 1, body size, and connector orientation with the current datasheet.
4. Modules such as ESP32 DevKit and buck boards: lock the exact board revision first. Module sellers often change PCB dimensions and pin labeling without changing the listing title, so a downloaded model is not trustworthy until checked against the board in hand.

Current project status: the PCB now contains 38 simple extruded clearance bodies generated from its footprint bounds. They help with basic height/enclosure work, but they are not real-looking manufacturer STEP models. The present generic symbols/footprints must be replaced with exact orderable parts before fabrication.

## Open and save

Task | Command / shortcut
Open project | File → Open Project, select GarageBeamSafety.PrjPcb
Save active / save everything | Ctrl+S / File → Save All
Properties panel | F11
Exit current tool | Esc; press twice if placement remains active
Undo / redo | Ctrl+Z / Ctrl+Y
Context help | Shift+F1

## Schematic editor

Task | Command / shortcut
Place component | Place → Part, or drag from Components
Place electrical wire | P, W
Place net label / power port | P, N / Place → Power Port
Place inter-sheet port | Place → Port
Move / drag preserving wires | M, M / M, D
Rotate / mirror | Space / X or Y
Edit during placement | Tab
Delete / zoom all | Delete / V, F

Electrical rule: use Place → Wire, not Place → Line. A line is only artwork. Net labels must touch the wire. This project uses power ports for GND, 3V3, 5V_LOGIC, and 12V_SENSOR.

## PCB editor: views and layers

Task | Command / shortcut
Board planning / 2D / 3D | 1 / 2 / 3
View Configuration | L
Next / previous enabled layer | Numpad + / −
Next / previous signal layer | Numpad * / Shift+Numpad *
Cycle enabled layers | Ctrl+Shift+mouse wheel
Single-layer mode | Shift+S
Flip / rotate 3D board | V, B / hold Shift+right-drag
Zoom to board | V, F

Routing behavior: changing signal layer during interactive routing inserts a via when the design rules permit it.

## PCB editor: placement and routing

Task | Command / shortcut
Place / move component | P, C / M, C
Move selected objects | M, S
Rotate / flip board side | Space / L while floating
Interactive routing | Ctrl+W, or Route → Interactive Routing
Place via | P, V; or change layer while routing
Free track | P, T — not a substitute for net-aware routing
Un-route selected | Route → Un-Route → Selected
Show connection lines | View → Connections → Show All
Repour polygons | Tools → Polygon Pours → Repour All
Run DRC | Tools → Design Rule Check
Update from schematic | Design → Update PCB Document

Keep screw terminals at board edges, optocouplers behind the beam terminals, and the ESP32 antenna at a board edge with no copper or tall parts beneath it.

## Board outline and 3D models

Task | Command / shortcut
Define board from outline | Select connected outline tracks, then Design → Board Shape → Define from Selected Objects
Edit board shape | 1, then Design → Edit Board Shape
Place STEP / 3D body | Place → 3D Body, select .step/.stp, align in Properties
Inspect component height | Select component, F11, inspect Height
Check result | 3

Model policy: this draft uses simple extruded clearance envelopes generated from footprint outlines. They are useful for placement and enclosure checks, but are not manufacturer-accurate STEP models. Replace each envelope after the exact purchased part is confirmed.

## Safe project workflow

1. Edit the schematic first.
2. Run Project → Validate PCB Project and resolve unintended errors.
3. Run Design → Update PCB Document and inspect every ECO.
4. Place connectors and mechanical constraints first, then protection, sensor channels, controller, and UI.
5. Route power and ground first, then beam inputs, then indicators.
6. Run DRC and inspect 3D before generating manufacturing outputs.

## Project-specific warnings

- This advisory detector must not replace the garage-door manufacturer's safety system.
- CLEAR requires active current from every enabled sensor. Open wiring, missing sensor power, and ESP32 startup remain unsafe.
- Do not order the current PCB until the actual DevKit, terminals, DC/DC module, sensors, footprints, and connector pin numbering are physically verified.
- The PCB is not the optical datum; alignment belongs to the adjustable wall brackets.

Garage Beam Safety engineering draft · Self-contained local HTML · Light print stylesheet included
