HenriquePereiraRosa/hardware_projects/garage_door_colision_detector/docs/pics/Garage_Drawinging_Screenshot_20260907_164558_Samsung Notes.jpg

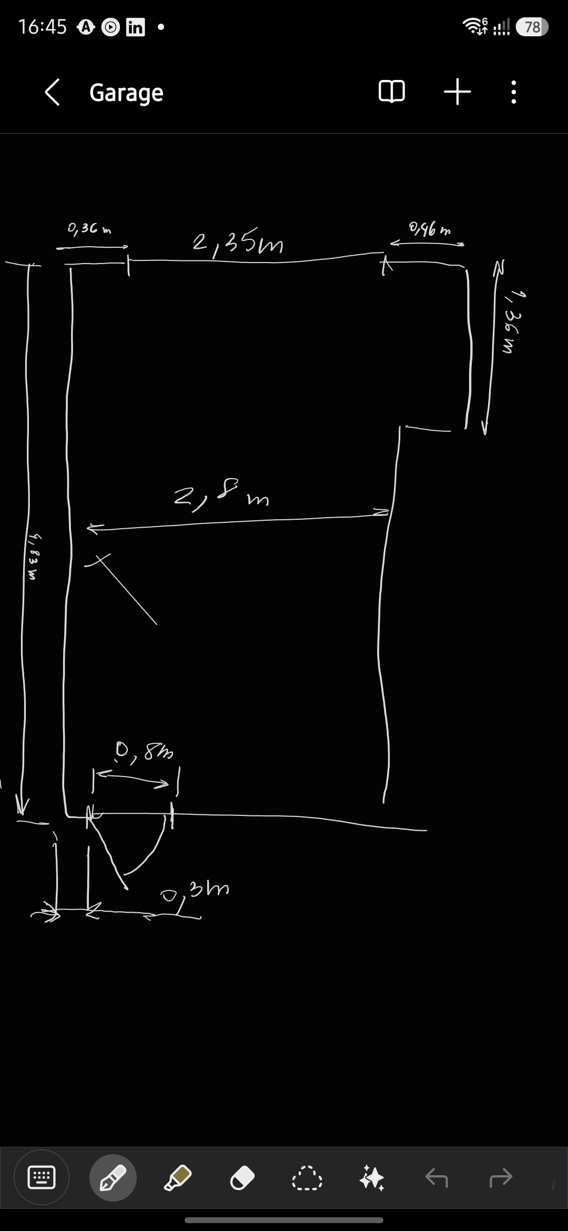
garage_door_colision_detector/docs/pics/Garage_Drawinging_Screenshot_20260907_164558_Samsung Notes.jpg
