HenriquePereiraRosa/hardware_projects/garage_door_colision_detector/output/altium-reports/before-folder-reorganization/ProfessionalOverviewCapture.png

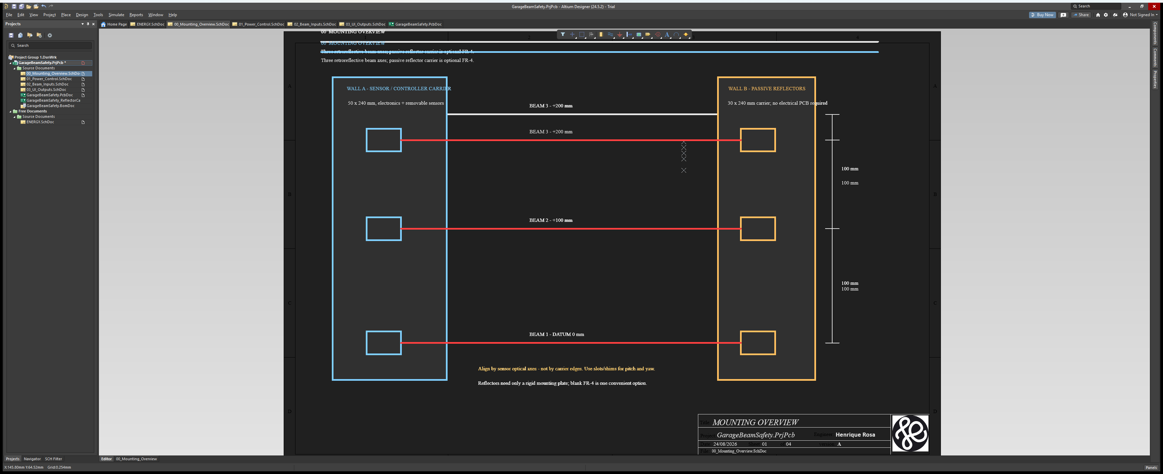
garage_door_colision_detector/output/altium-reports/before-folder-reorganization/ProfessionalOverviewCapture.png
