HenriquePereiraRosa/hardware_projects/garage_door_colision_detector/tmp/pdfs/d3_render/page-2.png

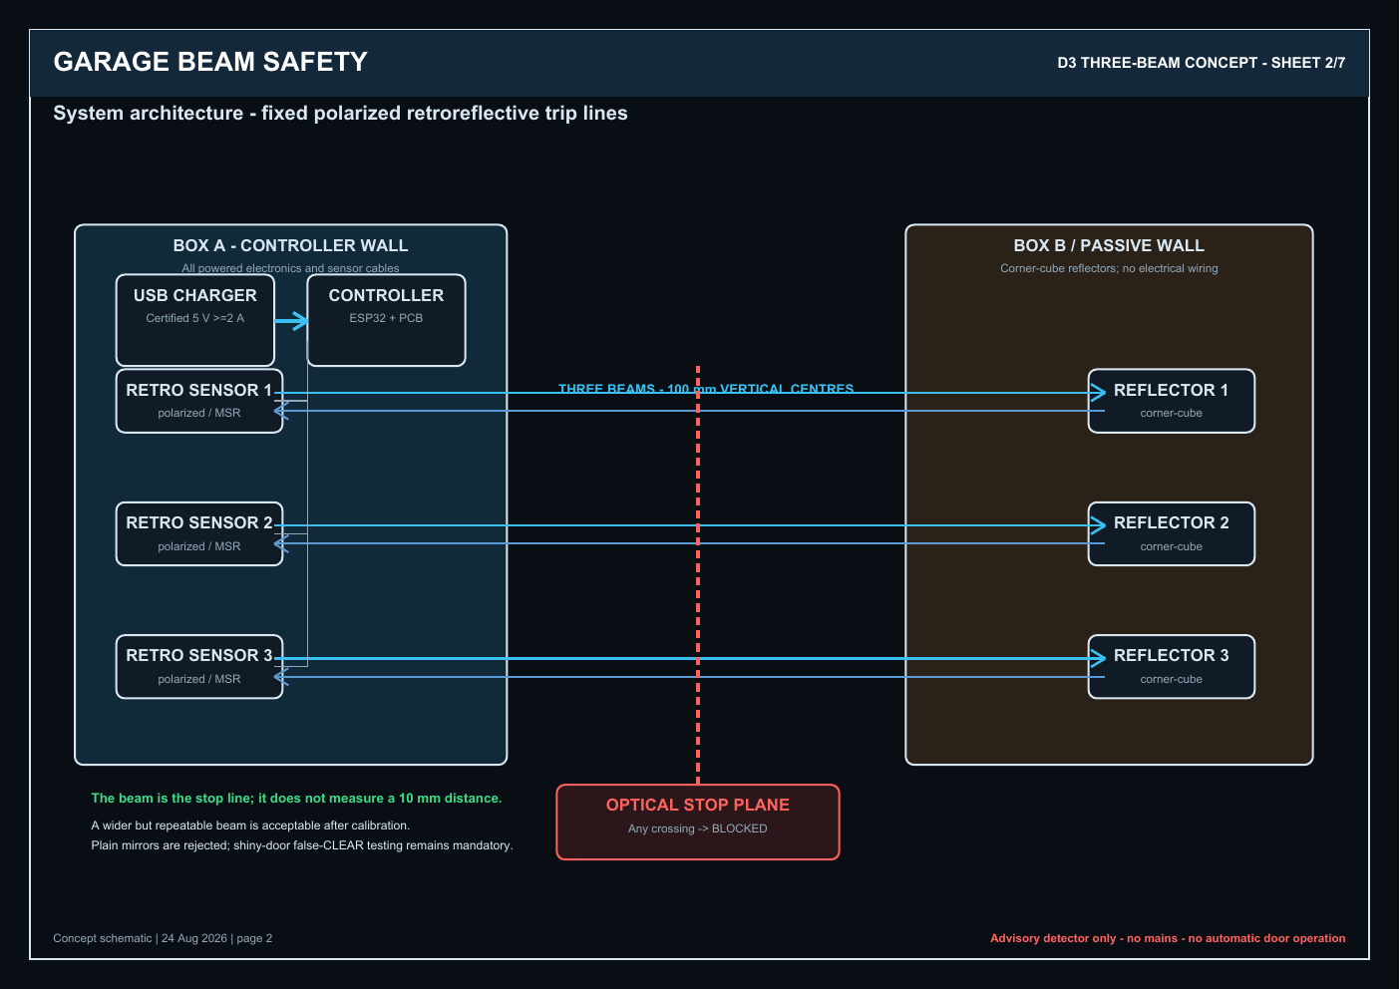
garage_door_colision_detector/tmp/pdfs/d3_render/page-2.png
