HenriquePereiraRosa/hardware_projects/garage_door_colision_detector/tmp/pdfs/d3_render/page-4.png

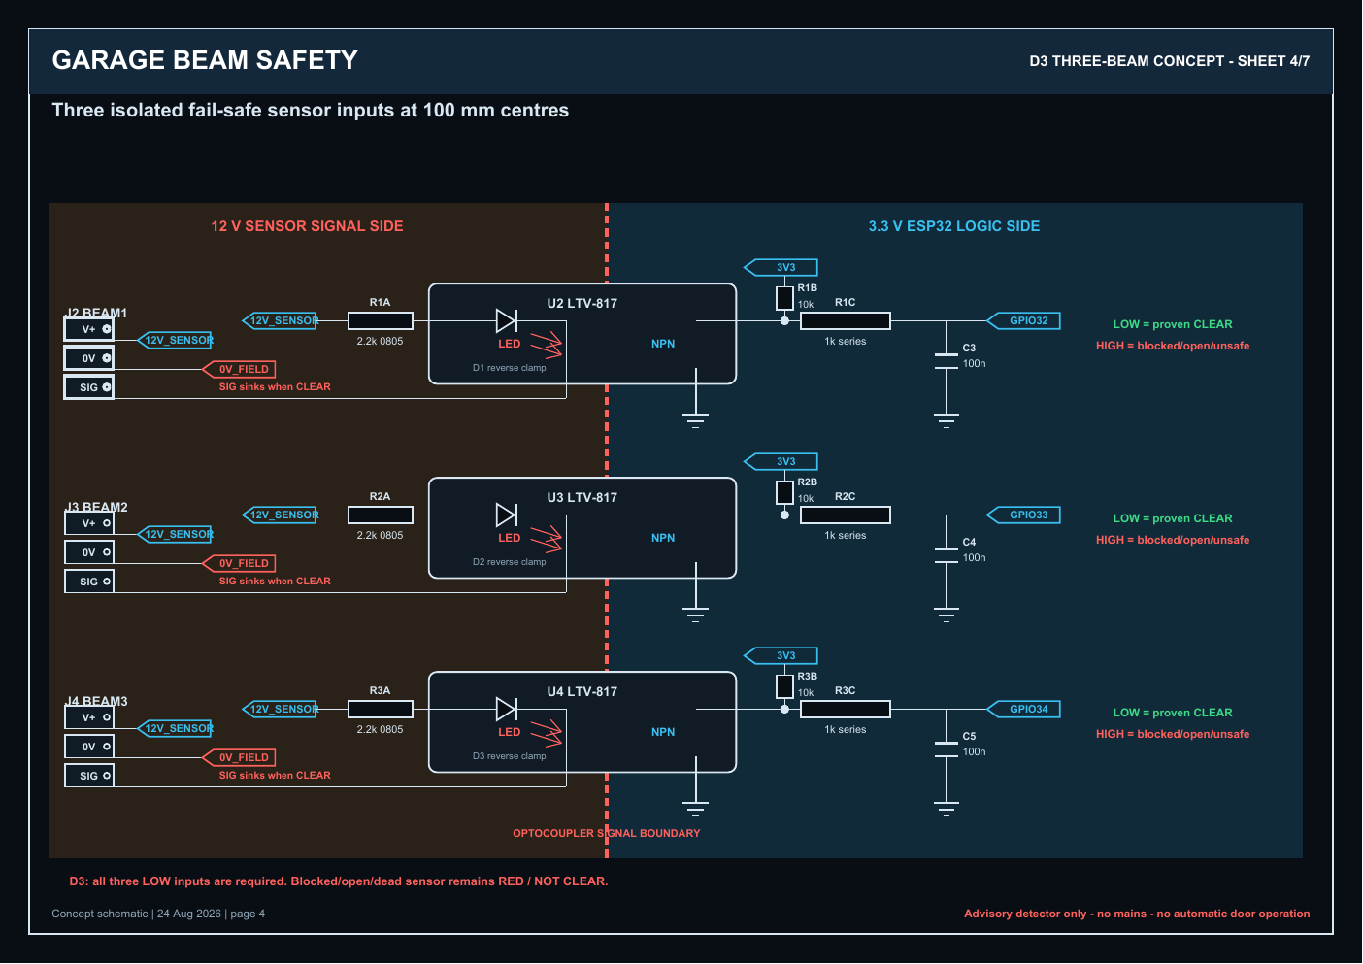
garage_door_colision_detector/tmp/pdfs/d3_render/page-4.png
