HenriquePereiraRosa/hardware_projects/garage_door_colision_detector/hardware/manufacturing/bom/POWER_STAGE_REVIEW.csv

Reference | Quantity | Manufacturer | Manufacturer Part Number | Electrical selection | Mechanical requirements | Status | Source
A2 | 1 | Murata | OKI-78SR-5/1.5-W36-C | 7-36 V input; 5 V output; 1.5 A rated subject to thermal derating; system design budget 1 A on 5 V rail | Vertical SIP; nominal envelope 10.4 x 8.64 x 16.5 mm; verify pin drawing before footprint release | Retained existing schematic part; footprint and STEP still pending | https://www.murata.com/-/media/webrenewal/products/power/datasheet/oki-78sr.ashx?la=en-us
C1 | 1 | Panasonic | EEUFR1E471 | 470 uF; 25 V; polarized; protected 12 V bulk | 10 mm diameter; 12.5 mm body length; 5 mm lead pitch | Generator intended-package clarified; native metadata not updated | https://industrial.panasonic.com/ww/products/pt/aluminum-cap-lead/models/EEUFR1E471
C5 | 1 | Panasonic | EEUFR1A471 | 470 uF; 10 V; polarized; 5 V bulk near DevKit input | 8 mm diameter; 11.5 mm body length; 3.5 mm lead pitch | Generator intended-package corrected; native metadata and footprint remain pending | https://industrial.panasonic.com/ww/products/pt/aluminum-cap-lead/models/EEUFR1A471
JP1 | 1 | Samtec | TSW-102-07-G-S | External 5 V disconnect; remove shunt before using programming USB | 2-position 2.54 mm header plus compatible shunt | Retain existing schematic; socket and shunt physical validation pending | https://www.samtec.com/products/tsw-102-07-g-s
