HenriquePereiraRosa/hardware_projects/garage_door_colision_detector/hardware/altium/SCHEMATIC_REPAIR_STATUS.html

# Schematic repair

3 September 2026 · Schematic review draft · PCB unchanged

## Open the actual project

Open GarageBeamSafety.PrjPcb in Altium, then open these sheets:

1. 01 — Power and ESP32
2. 02 — Four sensor inputs
3. 03 — Indicators, buzzer and test button

The files are native editable Altium schematic documents, not drawings pasted into a sheet. The mounting overview, PCB layouts, firmware and old purchasing BOM were not revised in this pass.

## What changed

- A1 now uses your supplied SnapEDA ESP32-DEVKITC-32E symbol, all 38 pins and its MODULE_ESP32-DEVKITC-32E footprint link. Both extracted native library files are included in the project. The complete development-board 3D model was visibly verified in Altium's PCB Library 3D view.
- Resistors, capacitors and diodes reuse conventional symbols from your ENERGY example. Old displayed template values were hidden; the visible comments now show the selected values. Other devices use editable functional symbols with explicit numbered pins and manufacturer-part parameters. They are not claimed to be downloaded manufacturer libraries.
- Added the fourth optocoupler input channel, explicit signal paths, base and button pull resistors, and a removable external-power jumper.
- Replaced the old incorrectly wired Q1 reverse-polarity stage with D6, a series SS34 Schottky diode. Use regulated 12 V input only. Verify the protected sensor rail remains at least 10.8 V under load for EX-L291.
- Retained the dark sheets and your title block. New schematic text uses Arial.

## Validation performed

Exported pin positions, wires, labels and model links directly from Altium. The read-only checker reports 48 unique components, 38 ESP32 pins, 93 connection assertions passed, and no shorts between named nets.

Run from the repository root: node hardware/altium/scripts/check_schematic_audit.cjs

This is a connectivity check, not a substitute for Altium ERC, pin-to-pad verification, electrical review or bench testing. Capacitor alternate display modes contain coincident duplicate pin records; the checker verifies they do not conflict.

The PCB SHA-256 remains CC69614426D8FCED292520EADF1CD58C13695B82C028087F7F95485D82276E71.

## Not ready for PCB manufacture or final purchasing

Only the ESP32 integrated library was supplied. Non-ESP32 footprints and STEP models remain pending and are labelled that way. Do not transfer the schematic to the old PCB or use the old BOM as an updated purchase list. Inherited hidden template metadata is not purchasing authority; use the explicit Manufacturer Part Number field and confirm the package before ordering.

Before layout: verify all remaining exact component packages and mappings, select matching socket headers for the development board, finish ERC and deliberate unused-pin treatment, and verify the prototype. The supplied board model does not by itself specify the socket stack height.

## Power and fault behaviour

Remove JP1 before connecting USB power. Do not feed the DevKit from USB and its external 5 V header simultaneously. The sensor input expects NPN Light-ON operation: output sinks current only when the optical path is clear. Do not choose NC/NO solely by the label on a listing; verify its light/dark truth table.

Open receiver wiring, loss of receiver power and an interrupted beam all produce an unsafe input. A signal short to ground, stuck-on output, or some other sensor failures can falsely report clear; this circuit does not diagnose every defect. The optocouplers share system ground and therefore do not provide system-level galvanic isolation. Advisory only; do not use as a door safety interlock.

## Recovery and editing

Original sheets and project are backed up in History/pre-library-repair-20260903/. The reproducible native script is scripts/RebuildRealSchematics.pas; running it replaces the three circuit sheets, so do not rerun after manual edits without making a fresh backup.

To inspect the ESP32 in 3D, open its PcbLib, click the canvas and press 3; press 2 for 2D. A schematic symbol is a functional drawing; its linked footprint contains the physical 3D body.

Reference: Espressif board pinout and exclusive power options (https://docs.espressif.com/projects/esp-dev-kits/en/latest/esp32/esp32-devkitc/user_guide.html) · Vishay SS34 specification (https://www.vishay.com/docs/88751/ss32.pdf)
