HenriquePereiraRosa/hardware_projects/garage_door_colision_detector/output/altium-reports/before-folder-reorganization/GarageBeamSafety.pdf

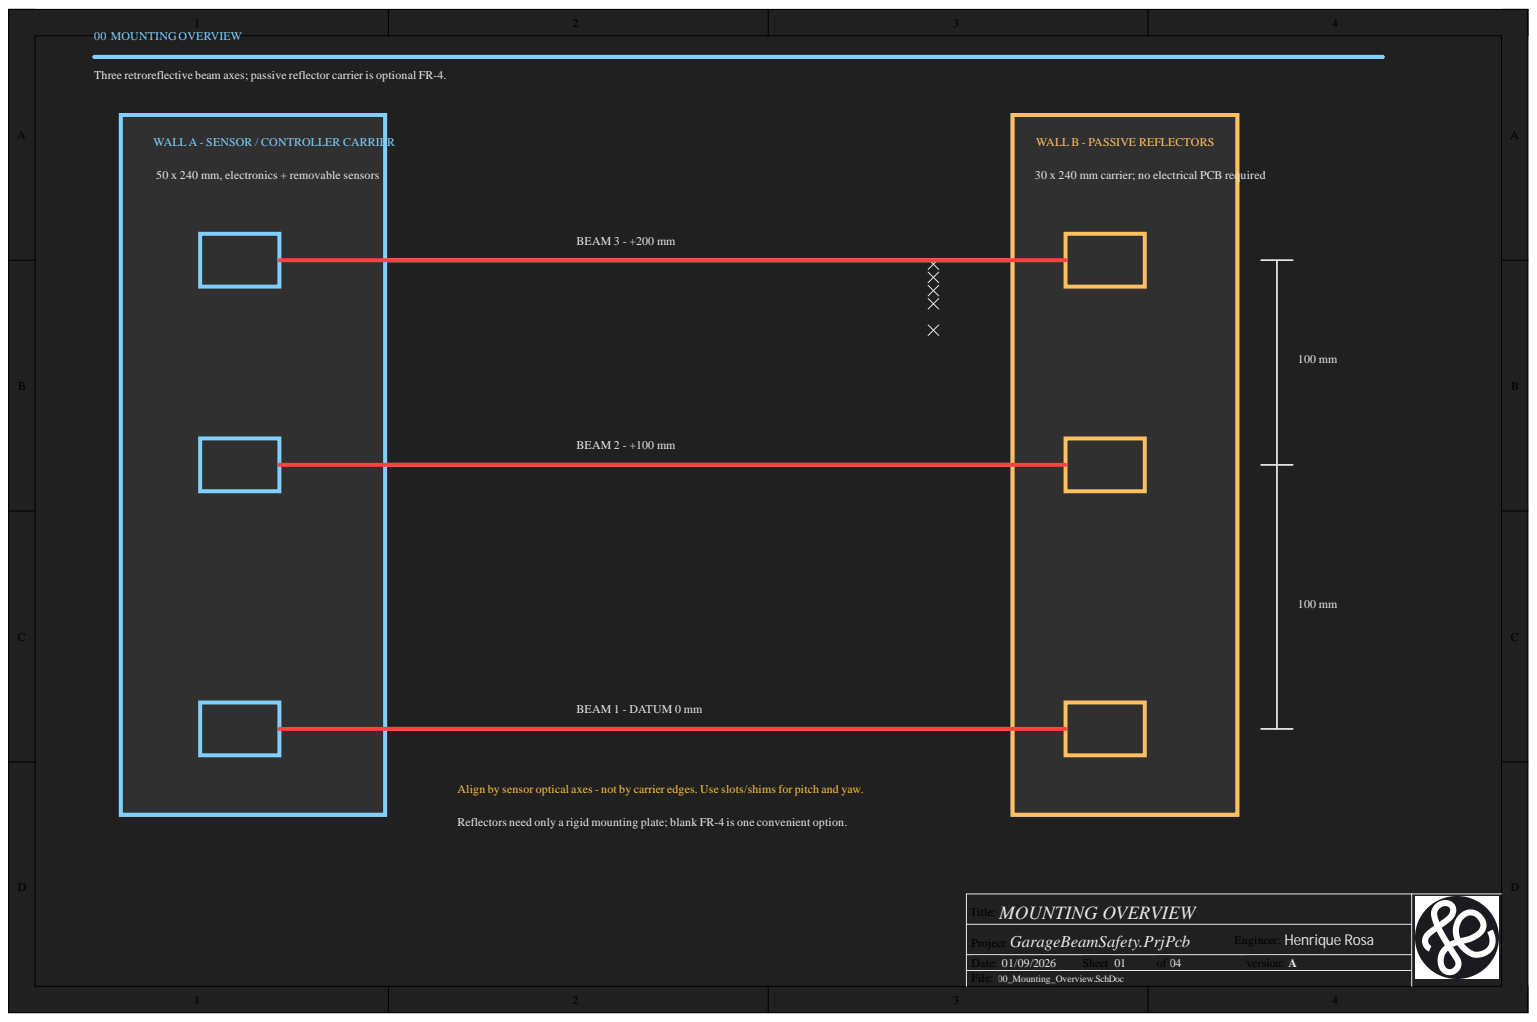
[picture p27: page 1]

Three retroreflective beam axes; passive reflector carrier is optional FR-4.

Align by sensor optical axes - not by carrier edges. Use slots/shimsfor pitch and yaw.

Reflectors need only a rigid mounting plate; blank FR-4 is one convenient option.

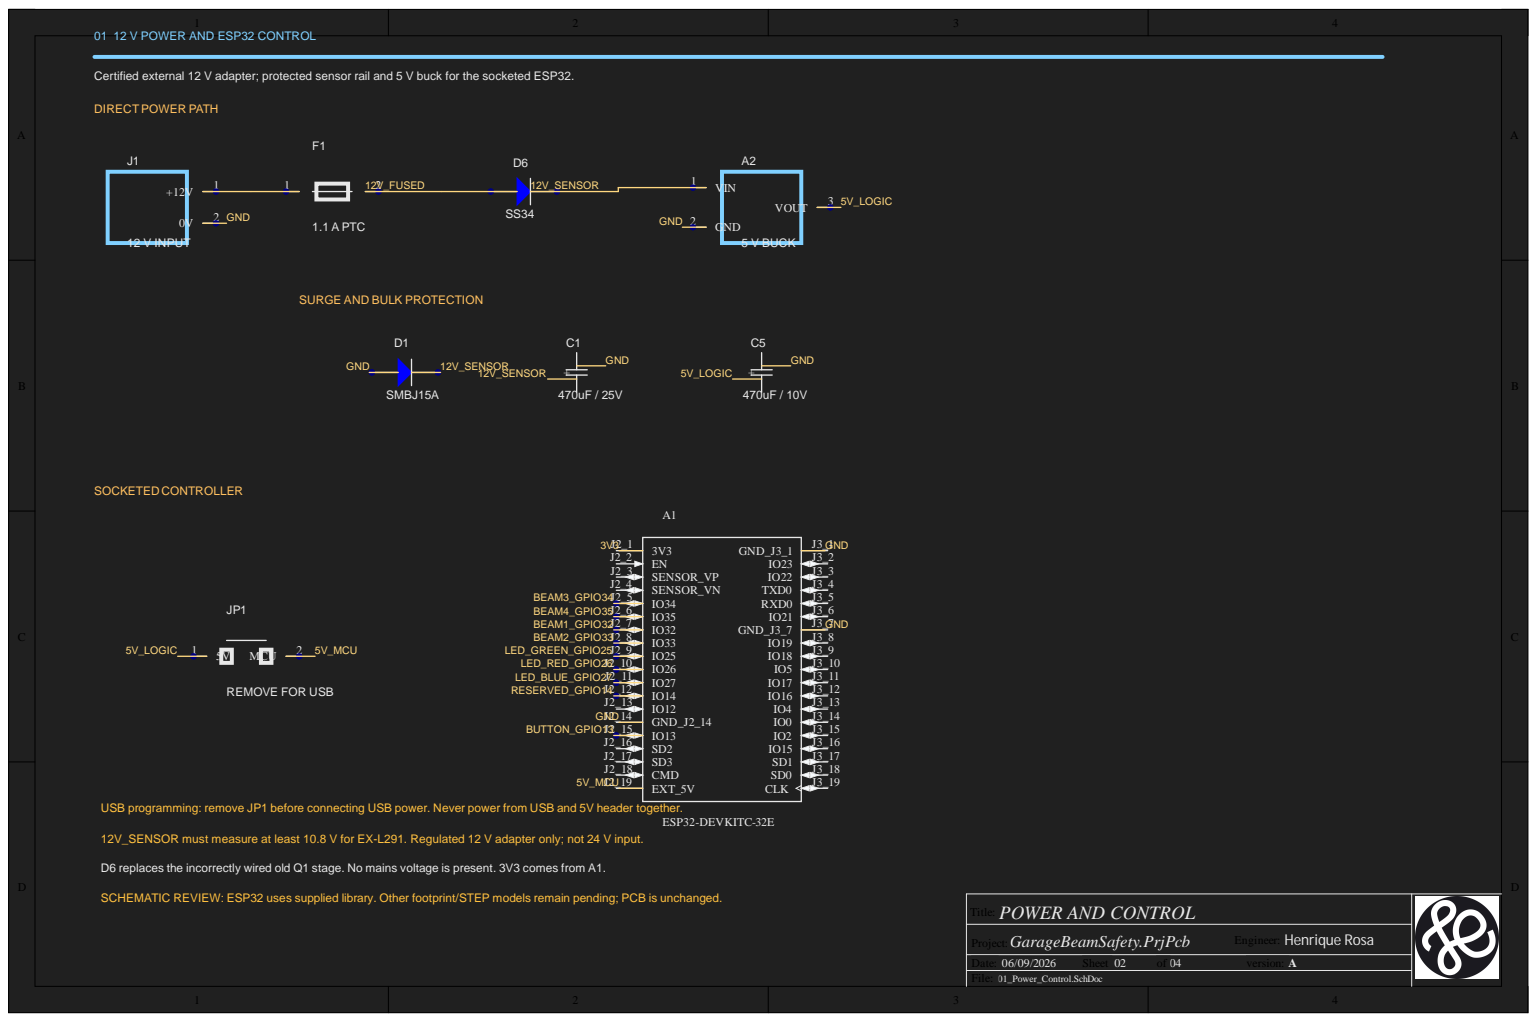
[picture p28: page 2]

Certified external 12 V adapter; protected sensor rail and 5 V buck for the socketed ESP32.

SURGE AND BULK PROTECTION

USB programming: remove JP1 before connecting USB power. Never power from USB and 5V header together.

12V_SENSOR must measure at least 10.8 V for EX-L291. Regulated 12 V adapter only; not 24 V input.

D6 replaces the incorrectly wired old Q1 stage. No mains voltage is present. 3V3 comes from A1.

SCHEMATIC REVIEW: ESP32 uses supplied library. Other footprint/STEP models remain pending; PCB is unchanged.

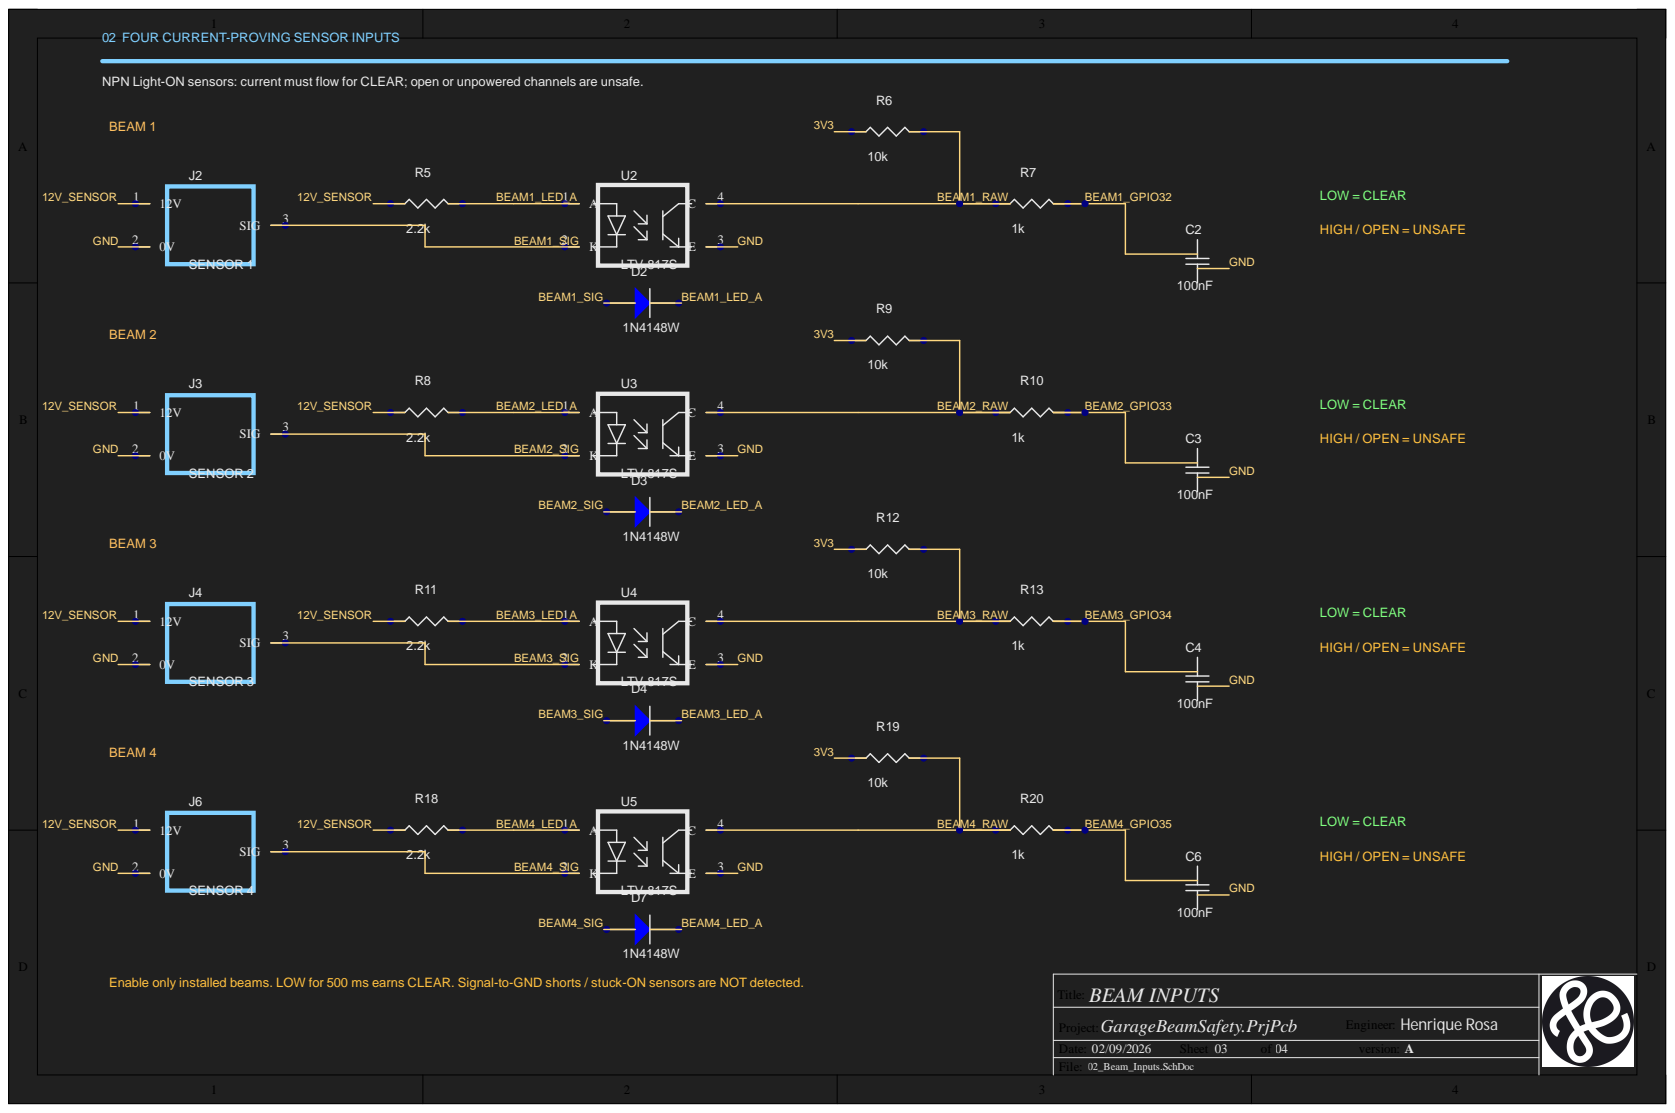
[picture p29: page 3]

02 FOUR CURRENT-PROVING SENSOR INPUTS

NPN Light-ON sensors: current must flow for CLEAR; open or unpowered channels are unsafe.

Enable only installed beams. LOW for 500 ms earns CLEAR. Signal-to-GND shorts / stuck-ON sensors are NOT detected.

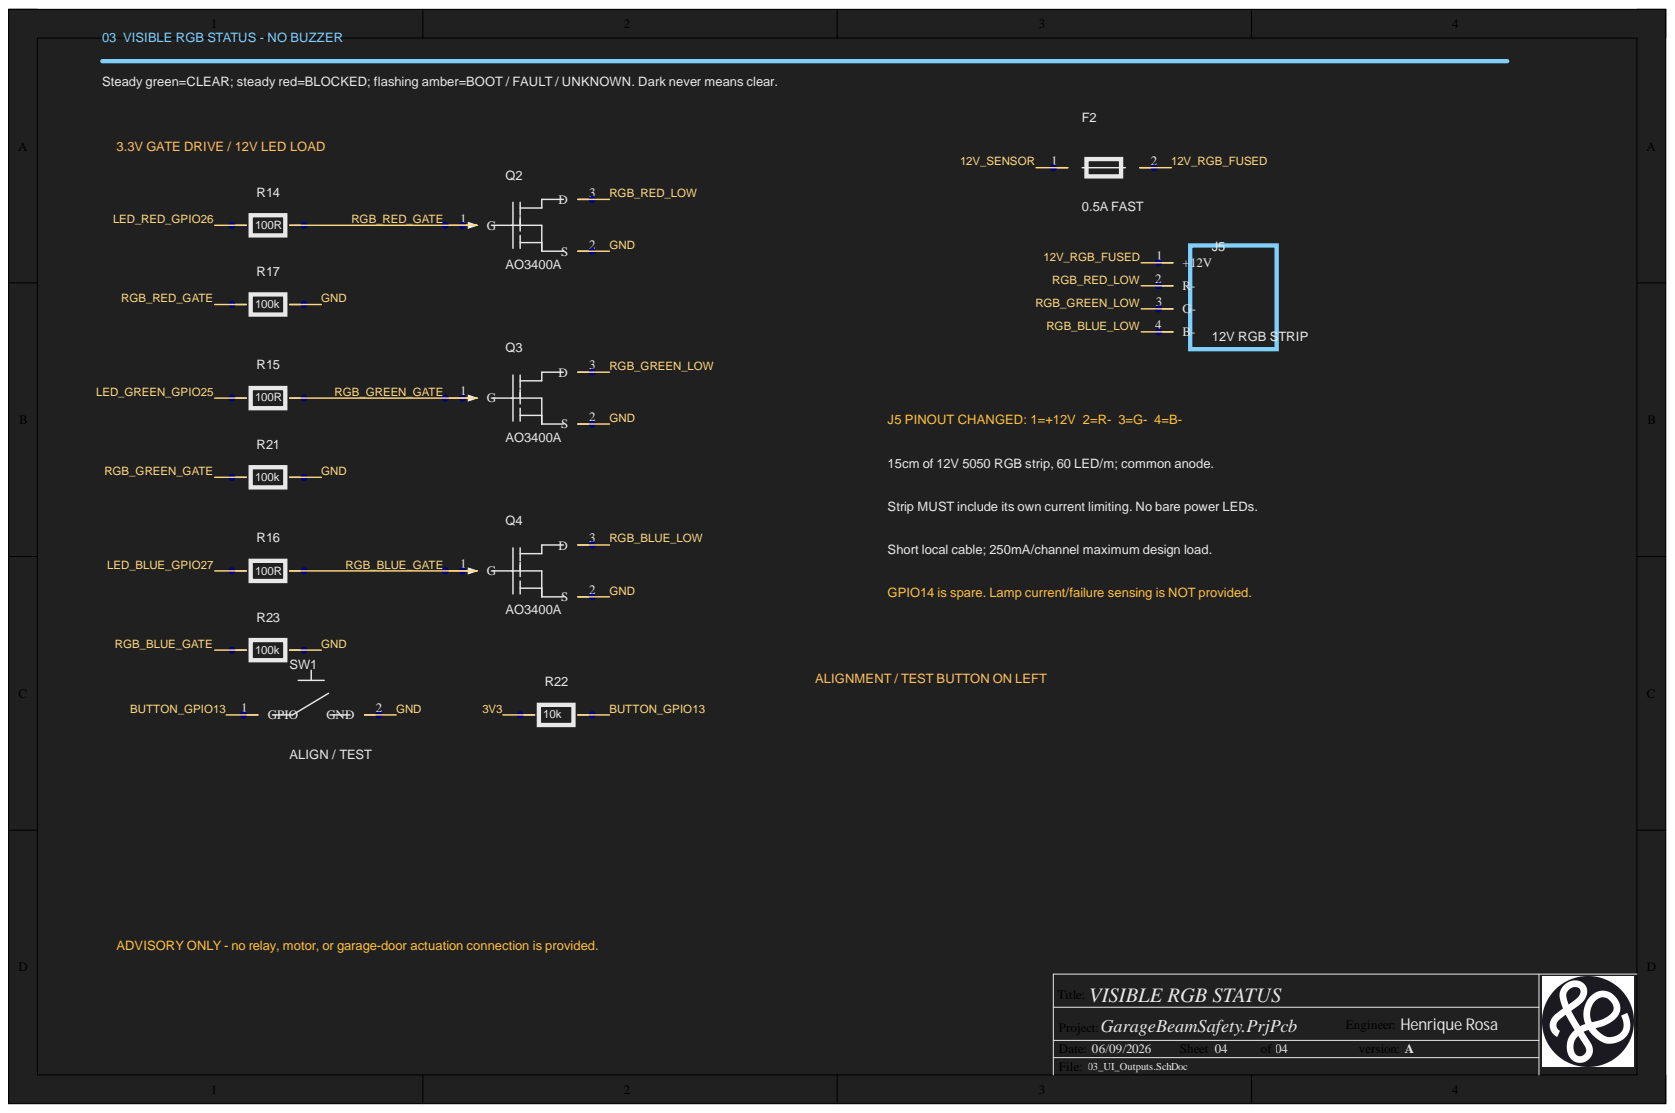
[picture p30: page 4]

03 VISIBLE RGB STATUS - NO BUZZER

Steady green=CLEAR; steady red=BLOCKED; flashing amber=BOOT / FAULT / UNKNOWN. Dark never means clear.

3.3V GATE DRIVE / 12V LED LOAD

15cm of 12V 5050 RGB strip, 60 LED/m; common anode.

Strip MUST include its own current limiting. No bare power LEDs.

Short local cable; 250mA/channel maximum design load.

GPIO14 is spare. Lamp current/failure sensing is NOT provided.

ALIGNMENT / TEST BUTTON ON LEFT

ADVISORY ONLY - no relay, motor, or garage-door actuation connection is provided.

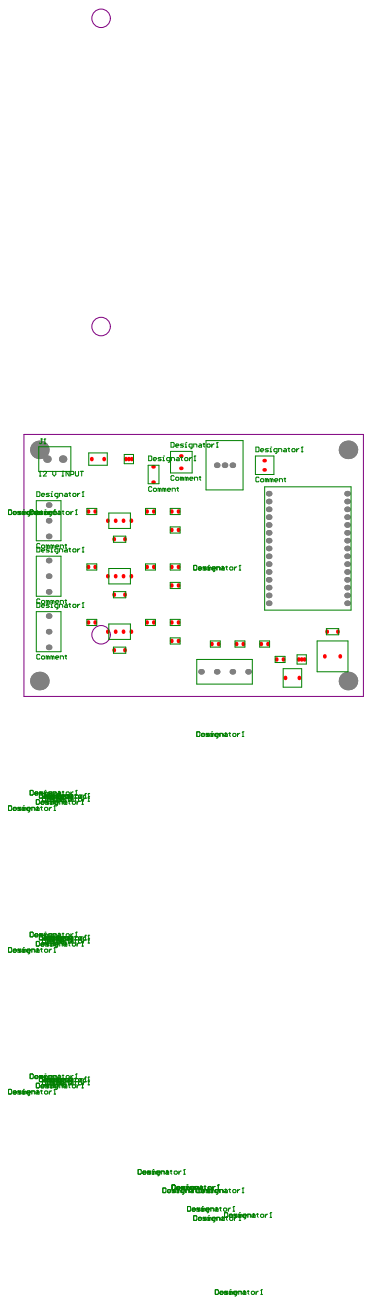
[picture p31: page 5]

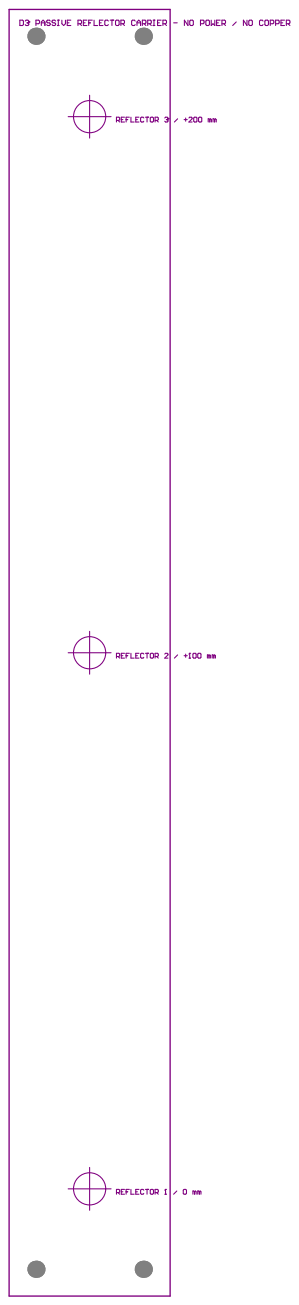
[picture p32: page 6]
