HenriquePereiraRosa/hardware_projects/(list of files, drawings)

Other design files:
garage_door_colision_detector/hardware/altium/00_Mounting_Overview.SchDoc
garage_door_colision_detector/hardware/altium/deprecated/2026-09-10-folder-reorganization/before/hardware/altium/GarageBeamSafety.PrjPcb
garage_door_colision_detector/hardware/altium/deprecated/2026-09-10-folder-reorganization/originals/hardware/altium/00_Mounting_Overview.SchDoc
garage_door_colision_detector/hardware/altium/deprecated/2026-09-10-folder-reorganization/originals/hardware/altium/01_Power_Control.SchDoc
garage_door_colision_detector/hardware/altium/deprecated/2026-09-10-folder-reorganization/originals/hardware/altium/02_Beam_Inputs.SchDoc
garage_door_colision_detector/hardware/altium/deprecated/2026-09-10-folder-reorganization/originals/hardware/altium/03_UI_Outputs.SchDoc
garage_door_colision_detector/hardware/altium/deprecated/2026-09-10-folder-reorganization/originals/hardware/altium/04_Optical_Heads.SchDoc
garage_door_colision_detector/hardware/altium/deprecated/2026-09-10-folder-reorganization/originals/hardware/altium/05_Installation.SchDoc
garage_door_colision_detector/hardware/altium/deprecated/2026-09-10-folder-reorganization/originals/hardware/altium/GarageBeamSafety.PcbDoc
garage_door_colision_detector/hardware/altium/deprecated/2026-09-10-folder-reorganization/originals/hardware/altium/GarageBeamSafety.SchDoc
garage_door_colision_detector/hardware/altium/deprecated/2026-09-10-folder-reorganization/unused-documents/GarageBeamSafety.SchDoc
garage_door_colision_detector/hardware/altium/deprecated/2026-09-10-workspace-cleanup/GarageBeamSafety_ReflectorCarrier.PcbDoc
garage_door_colision_detector/hardware/altium/deprecated/2026-09-10-workspace-cleanup/retired/GarageBeamSafety_ReflectorCarrier.PcbDoc
garage_door_colision_detector/hardware/altium/deprecated/2026-09-20-unused-schematic-copies/01_Power_Control.SchDoc
garage_door_colision_detector/hardware/altium/deprecated/2026-09-20-unused-schematic-copies/02_Beam_Inputs.SchDoc
garage_door_colision_detector/hardware/altium/deprecated/2026-09-20-unused-schematic-copies/03_UI_Outputs.SchDoc
garage_door_colision_detector/hardware/altium/GarageBeamSafety.PrjPcb
garage_door_colision_detector/hardware/altium/GarageBeamSafety.SchDoc
garage_door_colision_detector/hardware/altium/GarageBeamSafety_ReflectorCarrier.PcbDoc
garage_door_colision_detector/hardware/altium/History/celestial-20260909/00_Mounting_Overview.SchDoc
garage_door_colision_detector/hardware/altium/History/celestial-20260909/01_Power_Control.SchDoc
garage_door_colision_detector/hardware/altium/History/celestial-20260909/02_Beam_Inputs.SchDoc
garage_door_colision_detector/hardware/altium/History/celestial-20260909/03_UI_Outputs.SchDoc
garage_door_colision_detector/hardware/altium/History/celestial-20260909/04_Optical_Heads.SchDoc
garage_door_colision_detector/hardware/altium/History/celestial-20260909/05_Installation.SchDoc
garage_door_colision_detector/hardware/altium/History/celestial-20260909/GarageBeamSafety.PcbDoc
garage_door_colision_detector/hardware/altium/History/celestial-20260909/GarageBeamSafety.PrjPcb
garage_door_colision_detector/hardware/altium/History/celestial-20260909/GarageBeamSafety.SchDoc
garage_door_colision_detector/hardware/altium/History/celestial-20260909/GarageBeamSafety_ReflectorCarrier.PcbDoc
garage_door_colision_detector/hardware/altium/History/celestial-20260909/live-02_Beam_Inputs.SchDoc
garage_door_colision_detector/hardware/altium/History/celestial-20260909/live-03_UI_Outputs.SchDoc
garage_door_colision_detector/hardware/altium/History/celestial-20260909/live-GarageBeamSafety.PcbDoc
garage_door_colision_detector/hardware/altium/History/component-symbols-20260909/00_Mounting_Overview.SchDoc
garage_door_colision_detector/hardware/altium/History/component-symbols-20260909/01_Power_Control.SchDoc
garage_door_colision_detector/hardware/altium/History/component-symbols-20260909/02_Beam_Inputs.SchDoc
garage_door_colision_detector/hardware/altium/History/component-symbols-20260909/03_UI_Outputs.SchDoc
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
