HenriquePereiraRosa/hardware_projects/(commit log)

2026-09-09 added garage_door_colision_detector_proj
    [0001 EnergyMeter.PcbDoc, 00_Mounting_Overview.SchDoc, 01_Power_Control.SchDoc, 02_Beam_Inputs.SchDoc, 03_UI_Outputs.SchDoc, 04_Optical_Heads.SchDoc, 05_Installation.SchDoc, BOM_DRAFT.csv]
2026-09-28 middle revision of page 1, 2 and 3
    [00_Mounting_Overview.SchDoc, 01_Power_Control.SchDoc, 01_System_Overview.SchDoc, 02_Beam_Inputs.SchDoc, 02_Power_Control.SchDoc, 03_Beam_Inputs.SchDoc, 03_UI_Outputs.SchDoc, 04_Optical_Heads.SchDoc]
2026-10-18 restore renamed schematic links and archive obsolete sheets
